jvgcalites/FilipinoSignLanguageToTextConverterUsingKNN/Paper/Filipino Sign Language to Text Converter using K-Nearest Neighbor Algorithm.pdf

i

# Filipino Sign Language to Text Converter

# using K-Nearest Neighbor Algorithm

by

# John Vincent G. Calites

# Jean Tristan L. Reyes

# Glenn Christian D. Sioson

A Design Report Submitted to the School of Electrical Engineering,

## Electronics Engineering, and Computer Engineering in Partial Fulfilment of the Requirements for the Degree

## Bachelor of Science in Computer Engineering

## Mapúa University

## September 2020

ii

## Approval Sheet

## Mapua University

## School of EECE

This is to certify that I have supervised the preparation of and read the design report prepared by John Vincent G. Calites, Jean Tristan L. Reyes, Glenn Christian D. Sioson entitled Filipino Sign Language to Text Converter using K-Nearest Neighbor Algorithm and that the said report has been submitted for final examination on September 23, 2020 by the Oral

Examination Committee.

## Noel B. Linsangan Adviser

## As members of the Oral Examination Committee, we certify that we have

examined this design report, presented before this committee September 23,

## 2020, and hereby recommended that it be accepted in fulfillment of the design requirements for the degree in Bachelor of Science in Computer

Engineering.

Rafael G. Maramba | Meo Vincent C. Caya
Panel Member 1 | Panel Member 2

## Jumelyn L. Torres Committee Chair

This design report is hereby approved and accepted by the School of Electrical,

## Electronics and Computer Engineering in partial fulfillment of the requirements

for the degree in Bachelor of Science in Computer Engineering.

Alejandro H. Ballado, Jr.

## Dean, School of EECE

## iii

## AKNOWLEDGEMENT

## This design project would not be possible without the support of our

## adviser Engr. Noel Linsangan, his guidance kept our work on track from the

initial phase to the finalization of the design project.

We would also like to give thanks first to our parents and family members,

for being the support that was given to us.

## Our Design coordinator, Engr. Jumelyn L. Torres, for being considerate

and understanding to our group.

## We also would like to show our appreciation towards the client for this

design project which is Kaisahan ng Magulang at Anak na may Kapansanan Inc.

(KAISAKA), for giving us the opportunity to be of service to the PWD community.

## Lastly, to our friends and classmates who gives related information and

insights towards the development of this design project.

iv

## TABLE OF CONTENTS

TITLE PAGE | i
APPROVAL SHEET | ii
AKNOWLEDGEMENT | iii
LIST OF TABLES | vii
LIST OF FIGURES | viii
ABSTRACT | x
Chapter 1: DESIGN BACKGROUND AND INTRODUCTION | 1
A. Customer | 2
B. Needs | 2
C. Solution | 3
1. Objectives | 4
2. Scopes and Delimitation | 5
D. Differentiation | 5
E. Benefits | 6
Chapter 2: REVIEW OF RELATED DESIGN LITERATURE AND STUDIES | 8
Technology for Capturing Gestures | 8
Flex Sensor | 9
The mechanism for Filipino Sign Language (FSL) | 9
MPU6050 Gyro Sensor | 10
Force Sensitive Resistors | 11
Interfacing an Android Phone | 12
K-Nearest Neighbor Algorithm | 13
K-Nearest Neighbor Data Pre-Processing | 14
Chapter 3: DESIGN PROCEDURES | 16
A. Design Process Flow | 16

v

B. Hardware Development | 17
a. Conceptual Framework | 18
b. Block Diagram | 20
c. Schematic Diagram | 21
d. Isometric Model | 24
C. Software Development | 25
ATmega328p Microcontroller Programming | 26
Android Application Development | 28
Training Application Development | 34
D. Prototype Development | 37
a. PCB Design | 38
b. PCB Component Diagram | 39
c. Casing Model of the Prototype | 40
d. Bill of Materials | 41
E. Multiple Design Constraints | 42
F. Trade-offs | 43
G. Selection of Alternative Solution | 44
H. Impact of Design Solution | 46
I. Engineering Principles | 48
J. Modern Engineering Tools | 49
Chapter 4: TESTING, PRESENTATION, AND INTERPRETATION OF DATA | 50
A. Picking the K value | 50
B. Purpose of the Test | 50
C. Initial Assumptions | 50
D. Procedures in picking the K Value | 50
E. Data Table for the value of K | 52
F. Analysis and interpretations of collected data | 57
A. Testing the Android Application | 57
B. Purpose of the Test | 57
C. Procedures in Testing the Application | 58
D. Initial Assumption | 58
E. Data Table for the Android Application | 59

vi

F. Analysis and interpretations of collected data | 60
Chapter 5: CONCLUSION AND RECOMMENDATION | 61
Conclusion | 61
Recommendation | 61
Bibliography | 62
Appendix | 63
A. Article | 63
B. Operation’s Manual | 63
1. System Requirements | 63
2. Installation Procedures for the Android Application | 64
3. User’s Manual | 64
4. Troubleshooting Guides and Procedures | 64
C. Pictures of Prototype | 65
D. Data Sheets | 67
E. Android Application | 75

## vii

## LIST OF TABLES

Table 1.1: Differentiation from Previous Work | 6
Table 3.1: Tabulated Bill of Materials | 41
Table 3.2: Decision Martix of Design Constraints | 42
Table 3.3: Decision Matrix for Usability Constraint | 44
Table 3.4: Decision Matrix for Sustainability Constraint | 45
Table 3.5: Decision Matrix for Ergonomics Constraint | 46
Table 4.1: Picking the value of K (Trial 1) | 52
Table 4.2: Picking the value of K (Trial 2) | 53
Table 4.3: Picking the value of K (Trial 3) | 54
Table 4.4: Picking the value of K (Trial 4) | 55
Table 4.5: Picking the value of K (Trial 5) | 56
Table 4.6: Picking the value of K (Summary of 5 Trials) | 57
Table 4:7: Android Application Testing | 59

## viii

## LIST OF FIGURES

Figure 2.1: Comparison of Flex Sensor resistance | 9 (https://mymailmapuaedu-my.sharepoint.com/personal/gcdsioson_mymail_mapua_edu_ph/Documents/COE124D%20CALITES%20REYES%20SIOSON%20Final.docx)
Figure 2.2: Filipino Sign language alphabet | 10
Figure 2.3: MPU6050 Pin diagram and orientation | 11 (https://mymailmapuaedu-my.sharepoint.com/personal/gcdsioson_mymail_mapua_edu_ph/Documents/COE124D%20CALITES%20REYES%20SIOSON%20Final.docx)
Figure 2.4: FSR Connection | 12 (https://mymailmapuaedu-my.sharepoint.com/personal/gcdsioson_mymail_mapua_edu_ph/Documents/COE124D%20CALITES%20REYES%20SIOSON%20Final.docx)
Figure 2.5: Similar datapoints existing close to each other | 13
Figure 2.6: Sign Language Database | 14 (https://mymailmapuaedu-my.sharepoint.com/personal/gcdsioson_mymail_mapua_edu_ph/Documents/COE124D%20CALITES%20REYES%20SIOSON%20Final.docx)
Figure 3.1: Design Process Flow | 16
Figure 3.2: Conceptual Framework | 18 (https://mymailmapuaedu-my.sharepoint.com/personal/gcdsioson_mymail_mapua_edu_ph/Documents/COE124D%20CALITES%20REYES%20SIOSON%20Final.docx)
Figure 3.3: Block Diagram for the Design Project | 20
Figure 3.4.1: Schematic Diagram for the Main Module | 21 (https://mymailmapuaedu-my.sharepoint.com/personal/gcdsioson_mymail_mapua_edu_ph/Documents/COE124D%20CALITES%20REYES%20SIOSON%20Final.docx)
Figure 3.4.2: Schematic Diagram for the Battery Module | 22 (https://mymailmapuaedu-my.sharepoint.com/personal/gcdsioson_mymail_mapua_edu_ph/Documents/COE124D%20CALITES%20REYES%20SIOSON%20Final.docx)
Figure 3.5: Isometric Model of the Prototype | 24
Figure 3.6: ATmega328p Program Flowchart | 26
Figure 3.7: SendSensorValue module flowchart | 27
Figure 3.8.1: Android Development Flowchart | 29 (https://mymailmapuaedu-my.sharepoint.com/personal/gcdsioson_mymail_mapua_edu_ph/Documents/COE124D%20CALITES%20REYES%20SIOSON%20Final.docx)
Figure 3.8.2: Android Development Flowchart | 30 (https://mymailmapuaedu-my.sharepoint.com/personal/gcdsioson_mymail_mapua_edu_ph/Documents/COE124D%20CALITES%20REYES%20SIOSON%20Final.docx)
Figure 3.8.3: Extracting Sensor Values from a single string | 32 (https://mymailmapuaedu-my.sharepoint.com/personal/gcdsioson_mymail_mapua_edu_ph/Documents/COE124D%20CALITES%20REYES%20SIOSON%20Final.docx)
Figure 3.9: ClassifyGesture() Flowchart | 33 (https://mymailmapuaedu-my.sharepoint.com/personal/gcdsioson_mymail_mapua_edu_ph/Documents/COE124D%20CALITES%20REYES%20SIOSON%20Final.docx)
Figure 3.10: System Flowchart for Training Application | 35
Figure 3.11: Main Module PCB Design | 38
Figure 3.12: Battery Module PCB Design | 38

ix

Figure 3.13: Main Module PCB Component Diagram | 39
Figure 3.14: Battery Module PCB Component Diagram | 39
Figure 3.15: Components used in the Prototype | 40

x

## ABSTRACT

The Philippines has recognized Filipino Sign Language as the national sign language of the Filipino deaf and the official sign language of the government (RA 11106), this involves all the transactions involving the deaf, its usage in schools, broadcast media, and workplaces. This design project develops a glove that will translate Filipino Sign Language (FSL) to text using the K-Nearest Neighbor (KNN) algorithm. The device will only translate the alphabet instead of words. The device, while worn by the user, will do a real-time language translation through the means of capturing hand movements and gestures. The device is portable in the sense that it will only need an android phone in viewing the translated gesture while connected to the gloves through Bluetooth. After conducting several tests, it shows an accuracy of 89.63% when translating FSL

to text.

## Keywords: Android, Bluetooth, FSL, Gestures, Hand movements

## Chapter 1

## BACKGROUND AND INTRODUCTION

## Hearing impairment is the decreased ability to hear a sound which can

## occur at any age. Hearing disability can be acquired due to some genetic factors

## which can make a newly born child deaf, or people at any age can become deaf

due to complications, diseases, nerve damages, or injuries.

## Communication plays a vital role in society; it employs the transfer of

## information that is essential in developing relations. People who are deaf and has

other forms of hearing impairment hinders them to properly communicate.

## Although other forms of communication for them exists, such as sign language, it

## is not understood by many. Thus, the communication for those who have little to

## no knowledge of sign language and people with hearing disabilities must be

addressed.

## On October 30, 2018, the Philippines has recognized Filipino Sign

## Language as the national sign language of the Filipino deaf and the official sign

## language of the government (RA 11106), this involves all the transactions

## involving the deaf, its usage in schools, broadcast media, and workplaces. Since

## most of the schools use American Sign Language (ASL), various government

## offices such as the DepEd, CHED, and TESDA and all national and local

## government authorities involving the deaf are tasked to use the Filipino Sign

Language (FSL) as the medium of instruction for education.

## A. Customer

## The customer for this design project is Kaisahan ng Magulang at Anak na

## may Kapansanan Inc. (KAISAKA), a Community Based Rehabilitation (CBR)

## program for children and young adults with disability and their families based in

## the urban poor community of Manila; and the contact person of the said

## organization is Ms. Jeannifer Villanueva, the Program Coordinator. The

## organization started as a parish outreach program in 1989, KAISAKA, Inc. was

## registered in the Securities and Exchange Commission (SEC) as a People’s

## Organization (PO). On August 6, 1998, with mothers and people with disabilities

themselves as the frontrunner of the program.

## B. Needs

## After the initial interview with Ms. Jeannifer Villanueva, some of the

## officers of the said organization which directly deals with the PWD’s have low

## proficiency regarding Filipino sign language, thus they encounter difficulty when

## communicating with deaf people. Since they are a non-profit organization, they

## do not have sufficient funds to be able to hire translators all the time, it will also

## take time to fully learn and study Filipino Sign Language. As one of the officers

## said, they barely understand Filipino sign language, and most of the time they

## have a hard time understanding it; this is because their organization is not

## limited in accommodating the deaf, but a variety of PWDs. The need of the client

## is a device that can aid the officers in understanding deaf people. The device

## must also be easy to use, making it usable even by children. It must also be

portable in such a way that it can be used in everyday situations.

## C. Solution

## As a response to the need of the client, the group intends to create a

## device that will help by providing a means of training officers, volunteers, or

those persons with disabilities in Filipino Sign Language.

## The proposed solution is a glove that will translate Filipino Sign Language

## (FSL) to text, which can be viewed on an android phone. The device is portable

## in the sense that it will only need an android phone in viewing the translated

## gesture. The glove, while worn by the user, will do a real-time language

## translation through the means of capturing hand movements and gestures. The

## movement and gesture of the hand will serve as the input data, these data could

## be gathered by providing data to the microcontroller coming from the flex

## sensors, gyroscope, and accelerometer. The flex sensors will be responsible for

## taking the bending motion of the fingers. The gyroscope and accelerometer will

## take the position and speed of the hand in motion. Combining these three data

inputs, the interpretation of a specific gesture could be possible.

## The data coming from the sensors will then be sent by the microcontroller

## to the connected Android phone using a Bluetooth module. In the android

## phone, the hand movement and gesture are interpreted through the K-nearest

neighbor algorithm that predicts the output using the created mobile application.

## The force-sensitive resistor will be pressed for the device to start translating the

## sign language to text. The device will be powered by a rechargeable battery with

a charging module.

## In terms of how the device will be made, the group plans to design it as

## small as possible for the user to be able to move his hand and make gestures

## comfortably. The flex sensors will be placed along with the fingers. The gyro

## sensor is placed on the back of the hand while the force sensitive resistor will be

## placed at the thenar space (between the thumb and index finger). The

## microcontroller, Bluetooth module, and the battery along with the charging

## module will be placed on top of the wrist. A small and compact PCB will be

designed to connect all these components.

## 1. Objectives

## In this design project, the group intends to develop a real-time language

## translation of Filipino Sign Language (FSL) to text. Specifically, the group wants

## to achieve the following:

## 1. To use a flex sensor, gyroscope, and accelerometer to capture hand

movements and gestures.

## 2. To create a portable device utilizing an Android application capable of

translating Filipino Sign Language (FSL) to text.

3. To use the K-Nearest Neighbor Algorithm for classifying gestures.

## 2. Scopes and Delimitation

## The android device only translates the alphabets in Filipino Sign Language

## (FSL) to text. Only the right-hand glove will be designed and built for

## gesture recognition. The output text will be based only on the data

## gathered from the glove. Facial expressions, head movement, body

## positions, and proximity of the hands to each other are not translatable by

## the device. The microcontroller will only send the data coming from the

sensor to the android phone once the force sensitive resistor is pressed,

## this is done so that it will only send data to the android phone when the

## user wants to fingerspell a letter and to avoid transmitting data when it is

## idle. Only one android phone can be paired to the glove to view the

## translated texts. The android phone will be used to process the data and

## convert the signals to text rather than the ATmega328p microcontroller

since KNN uses large amounts of resources.

## D. Differentiation

## A thesis published from Mapua Institute of Technology Manila: MIT School

## of Graduate Studies, “A heuristic decision tree algorithm for Filipino Sign

## Language (FSL) translator implemented using accelerometers with Bluetooth

## connectivity to a host PC” (Piscasio,2014) was found to have a similar problem to

## solve, to bridge the communication gap between signers and non-signers. There

## are however some differences in the implementation of the solution to the

## problem. The design to be implemented aims to make the device portable for it

## to be usable in an everyday situation as compared to the work of Piscasio that

## uses a PC as the output and processing device. There are also differences in the

## components, method, and technology used as seen in Table 1.1. Our group will

## use the ATmega328p microcontroller and translate Filipino Sign Language (FSL)

## to text and will have a rechargeable battery. Lastly, the machine learning

## algorithm that the group will use is the K-Nearest Neighbor algorithm, unlike the

similar device which uses a Heuristic Decision Tree.

## Table 1.1: Differentiation from Previous Work

Design Solution | Nearest Similarity
Technology | Microcontroller: ATmega382p Sensors: Flex Sensors Force Sensitive Resistors MPU6050 Sensor Algorithm: K-Nearest Neighbor | Microcontroller: ATmega2560 Sensors: Accelerometer Algorithm Heuristic Decision Tree
Functionality | Converts Filipino Sign Language to Text | Converts Filipino Sign Language to Text
Features | Portable Rechargeable Uses Android phone | Uses PC

## E. Benefits

## The product is made specifically to benefit the officers of the organization

## who have little knowledge about Filipino Sign Language (FSL) and have a hard

## time understanding it. This product will also benefit the deaf people of whom the

## organization helps, since they can now train by themselves and their knowledge

## will be reinforced by showing them if their gesture is correct. The product is

## being designed and built as a compact and portable device, making it easier to

## be carried around, thus it can be used anywhere when needed. The device can

## help those who are beginners in terms of FSL for them to learn the basics of sign

language which is fingerspelling.

## Chapter 2

## REVIEW OF RELATED LITERATURE AND STUDIES

## This chapter involves related studies and developments of the design of

## the Filipino Sign Language (FSL) to text converter. The researchers will give an

## overview to its readers how this study’s design works and develop a new

concept.

## Technology for Capturing Gestures

## Language translation can be done through the use of electromagnetic

sensors that have direct contact with the skin along with accelerometers,

## gyroscopes, and vision through means of a supervised machine learning

## algorithm requiring the user up to 30 minutes of training per gesture. The

## algorithm consists of different type of machine learning algorithm which includes

## Naïve Bayes, Nearest Neighbor, decision trees, and vector machines which

## enables the comparison for accuracy of 40 common gestures. An important

## consideration in creating a communication device is by following the safety

## standards. To bring a device as close as a commercial product, it must follow the

safety standard like prevention of shorting wires that might cause injuries. Also,

## electrocution must be prevented through means of having a total voltage lower

## than 25V which was referred to as the lowest lethal voltage by a research paper

completed at the City University of New York.

## Flex Sensor

## A flex sensor is a variable resistor, its resistance increases as the

## component bends. One side of the Flex Sensor is made out of polymer ink which

## has conductive particles. When the flex sensor is straight, it gives the polymer

## ink resistance of approximately 30kΩ, when bent, it gives around 50kΩ~70kΩ

depending on the degrees it is bent.

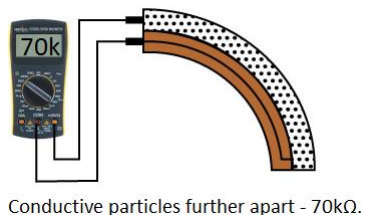
[picture p13: figure]
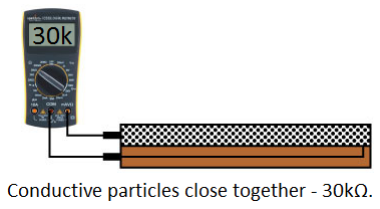
[picture p14: figure]

A voltage divider will be required in incorporating the sensor to a project,

## it must be connected in the Arduino’s A0 port and the other end at 5V. When

## developing the program, the straight and bend resistance must be declared. And

then calculate for the resistance using various formulas.

## The mechanism for Filipino Sign Language (FSL)

## Sign Language is not an international language, but those who use sign

## language may understand fellow sign language users quickly because there are

## universal features in sign languages as stated by the World Federation of the

## Deaf. Filipino Sign Language is used by deaf people in the Philippines, this is

## distinct in comparison to the American Sign language (ASL) because Filipino sign

## Figure 2.1: Comparison of Flex Sensor resistance

language poses unique structural features in terms of its phonology, morphology,

syntax, and discourse.

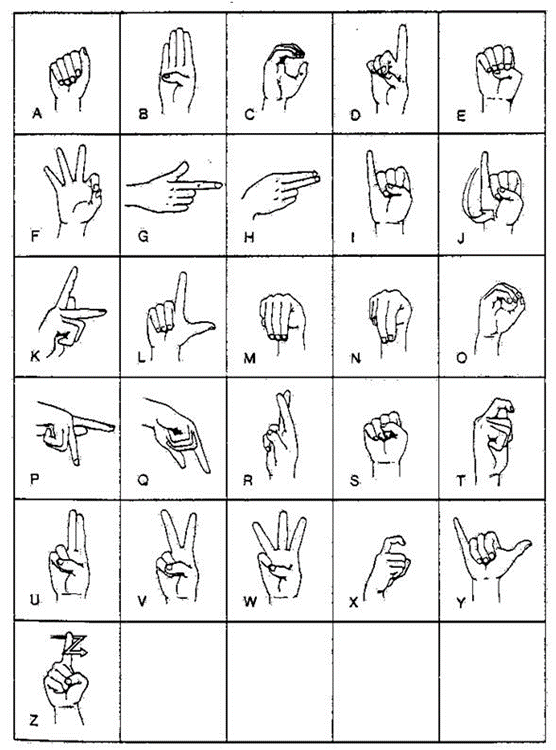
[picture p15: figure]

## Figure 2.2: Filipino Sign language alphabet

## MPU6050 Gyro Sensor

## The MPU6050 is an 8-pin with 6 axis chip that combines the

## accelerometer and a gyro. To use the Gyro Sensor, pin 18 (GND) must be

## connected to the ground, 3.3V must be connected to pin 13 (VDD). Pin 23 (SCL)

## and Pin 24 (SDA) of the MPU6050 must be connected to the A4 pin and A5 pin of

## the microcontroller respectively. The data pin is directly connected to the digital

## PINs 10-13. To program using the MPU6050 Sensor, a library must be imported

## from GitHub and install it in the IDE. This library supports reading and displaying

## gyro and accelerometer readings. The Gyro sensor uses the earth’s gravity to

## determine the x-axis, y-axis, and z-axis position of the sensor while the

accelerometer detects based on the movement.

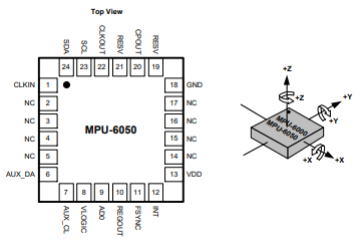
[picture p16: figure]

## Force Sensitive Resistors

## FSRs are simple and low-cost sensors that allow the detection of pressure

## and weight. It is made of 2 layers which are the flexible substrate with printed

## semiconductor and a flexible substrate with printed interdigitating electrodes

## which are separated by a spacer. The resistance of the FSR changes as pressure

## is applied. When no pressure is applied, the FSR acts as a resistor, as pressure is

## applied the resistance decreases. One end must be connected to a 5V supply

while the other end is connected to the analog input.

## Figure 2.3: MPU6050 Pin diagram and orientation

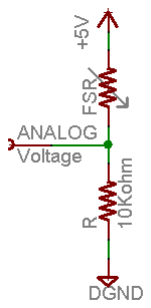
[picture p17: figure]

## The voltage of the Force Sensitive Resistor can be computed as vo = vcc (

R
R+FSR),

## whereas Vo is the output voltage, Vcc being equal to 5V, FSR being the resistance

## of the force-sensitive resistor when 0 pressure is applied and lastly R being the

value of the pull-up resistor.

## Interfacing an Android Phone

## Interfacing an Android phone with Arduino via Bluetooth is possible

through the use of a Bluetooth module. Connect first the Pin 0 (RX) to TX,

## TX(Pin 1) to RX, VCC, and ground accordingly. Turning on the microcontroller

## also powers up the HC 05/06 Bluetooth module, the android phone needs to be

## paired via Bluetooth by entering the default password which can either be 1234

## or 0000. After a successful connection, data transfers via Bluetooth can now be

used.

## Figure 2.4: FSR Connection

## K-Nearest Neighbor Algorithm

## It is a supervised machine learning algorithm that is dependent on labeled

## data inputs to learn and will produce an output based on the newly given input

## unlabeled data. This is commonly used to solve classification and regression

problems. This algorithm assumes that similar things exist in proximity.

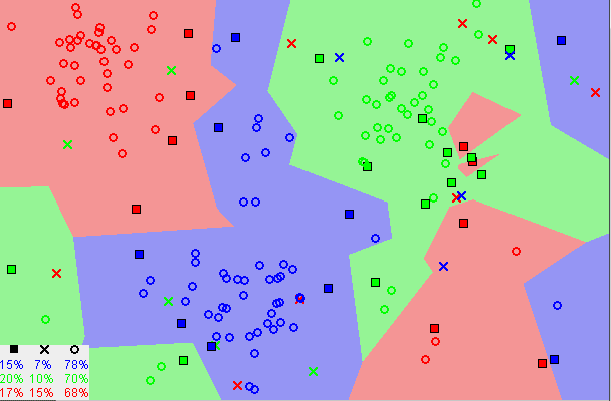
[picture p18: figure]

## Figure 2.5: Similar datapoints existing close to each other

## Figure 2.5 shows that most of the time, similar data points are located

## close enough from each other. The KNN algorithm bases on this assumption

## being true, it captures the idea of similarity. Several steps are required in using

the K-Nearest Neighbor algorithm, these are as follows;

## 1. Load the data

## 2. Initialize the value of K to the number of chosen neighbors

## 3. For each sample data, compare the distance between the query

## example and current example then add the distance along with its

## index to an ordered collection

## 4. Sort the ordered collection of distances and indices in ascending order

## 5. Pick the first K entry

## 6. Get the labels of the selected entry

## 7. Return the mean or the mode of the K labels if it is a regression

## (mean) or classification (mode)

## K-Nearest Neighbor Data Pre-Processing

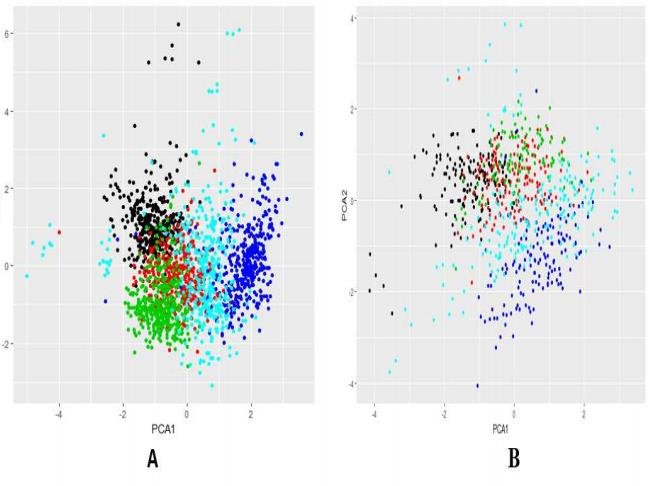
[picture p19: figure]

## When implementing a complex prototype selection algorithm with regards

## to a large scale of data, the execution time needed to accomplish the task is long

## due to the repeated iterations in the training set. The gloves acquire the data

## from the flexion of the sensors when performing different sign languages, thus a

## Figure 2.6: Sign Language Database

## large number of data are stored, which needs to be pre-processed. The data

which are like the noise to the database are then removed. For data acquisition,

the gesture must be done for several minutes for one minute in each position.

## These data are stored in the new matrix T, of m x n order wherein the value of

## m is the number of samples and the variable n is the number of attributes that

represent the data.

Figure 2.6 illustrates in part A the matrix T and in part B the matrix U,

colors: black (number 1), red (number 2), green (number 3), blue (number 4),

and cyan (number 5).

## Chapter 3

## DESIGN PROCEDURES

## In compliance with the client’s needs, the researchers have designed the

## Filipino Sign Language (FSL) to text converter. In this chapter, the stages of

designing the system that will comply with the needs of the client are discussed.

## A. Design Process Flow

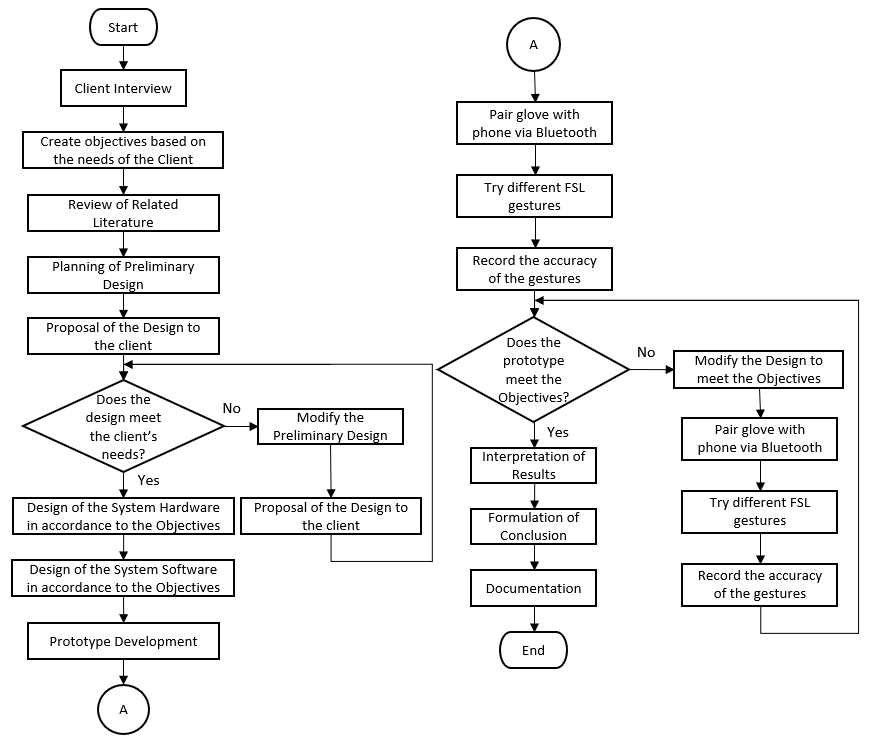
[picture p20: figure]

## Figure 3.1: Design Process Flow

## Figure 3.1 illustrates the flow of design development. First, the client was

## interviewed to know their needs with regard to the existing problems of persons

## with physical disabilities. Then the objectives were established under the needs

## of the client. The researchers then read documents, journals, and previous

## studies to have an idea of how the problem will be solved. After formulating

## concepts for the solution, the next step is to meet and discuss with the clients if

## the proposed solution meets the client’s needs, if not, the design is modified and

## is discussed again with the client. If the design is approved by the client, the

## next step is to design the hardware part of the design which includes the listing

## of components needed and creating the schematic diagram. Next is to design the

## software part of the system, this will describe the logical flow of the system using

## programming. Then the hardware design will be implemented to form the actual

## hardware as well as the software to be uploaded into the microcontroller to build

## the prototype of the system. Testing and data gathering will be conducted to see

## if the prototype functions in accordance with the objectives. The glove and the

## app are tested with different gestures, and the accuracy for each gesture is

## recorded. If it meets the objectives, the results are interpreted and conclusions

## are formed, if not then the current prototype is modified and tested until the

## objectives are met. The last step of the design process flow is the documentation

of the project.

## B. Hardware Development

## Step-by-Step Procedure of Hardware Development

## 1. Identify the needed components to be used; the major materials are:

a. ATmega328p – The microcontroller that will be used.

## b. HC05 Bluetooth Module – Used in transmitting converted FSL to an

android phone.

c. Flex Sensor – Used to measure the flexion of the fingers.

## d. FSR 400 – Used to identify whether the device should translate or

not.

## e. MPU6050 – Used to measure the orientation of the hand and the

speed at which the hand is moving.

f. TP4056 Module – Used to charge the batteries.
g. Gloves – Used to hold the components.
h. 14500 Li-Ion Battery – Used to power the device.
2. Construct a block diagram that will show the hardware design flow.
3. Create a schematic diagram for the FSL Translator Circuit.

## a. Conceptual Framework

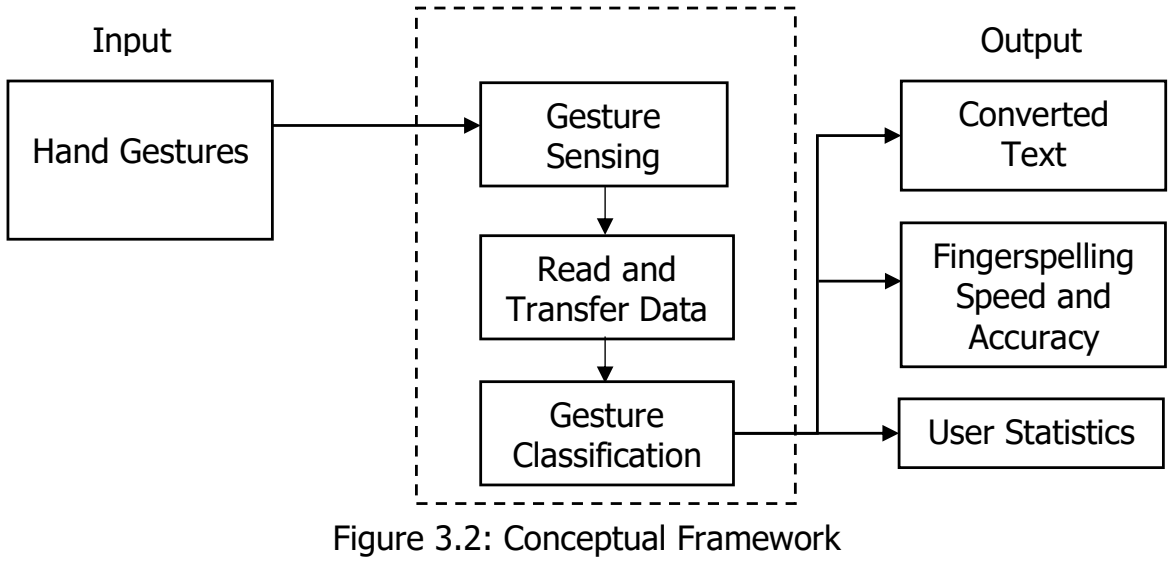
[picture p21: figure]
Fingerspelling Speed and Accuracy; User Statistics; Input; Process; Output; Hand Gestures; Converted Text; Gesture Sensing; Read and Transfer Data; Gesture Classification

## Figure 3.2: Conce Figure 3.2: Conceptual Framework ptual Framework

## Figure 3.2 shows the conceptual framework of the system. The input will

## come from the hand gestures of the user that corresponds to the Filipino Sign

## Language (FSL). There will be sensors providing the data from the hand

## gestures. The data will be read by the microcontroller and will be sent to the

## android phone via Bluetooth connection. It will only be sent to the android

## application once the FSR is pressed. In the android phone, the data will be

## processed using the Machine Learning Model that is trained using the K-Nearest

## Neighbor Algorithm which finds the most frequent label for a given value of K on

## the trained data. Lastly, the label’s equivalent text will be displayed on the

## android phone. The user can also see how fast and accurate his/her

## fingerspelling is after fingerspelling a sentence, this contains the words

## translated per minute and accuracy. The user can also view their progress

through a line graph displaying their records which includes the games played,

speed record, average speed, and accuracy.

## b. Block Diagram

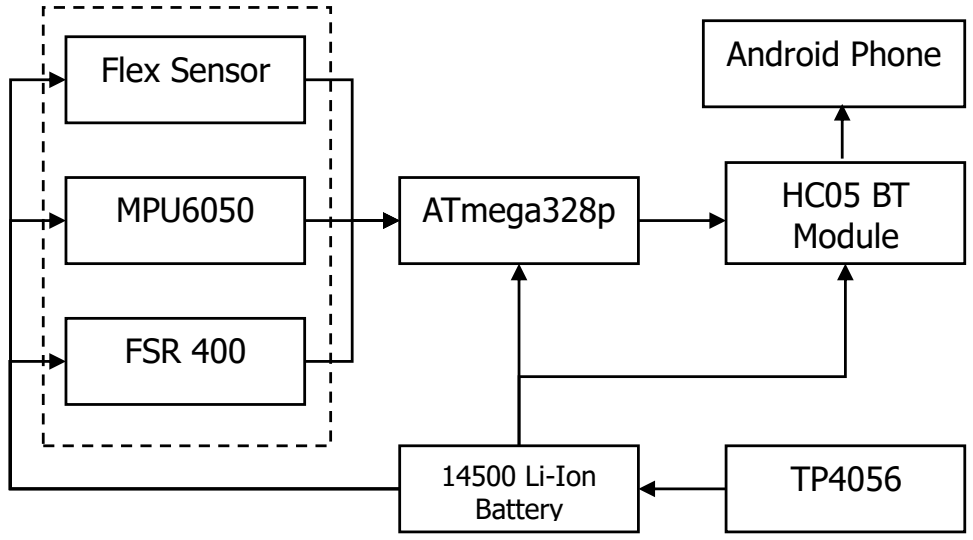
[picture p22: figure]
HC05 BT Module; Flex Sensor; MPU6050; FSR 400; ATmega328p; 14500 Li-Ion Battery; Android Phone

## Figure 3.3: Block Diagram for the Design Project

Figure 3.3 illustrates the interaction among the components of the device.

## The microcontroller ATmega328p will serve as the controller for the system in

## which it controls and reads data from the different components. The

ATmega328p reads the resistance coming from the flex sensor, the acceleration,

## and position from the MPU6050, and if the device is ready to translate by

## pressing the FSR. The microcontroller then sends it to the android phone through

## means of Bluetooth connection. Then, the smartphone uses the data gathered by

## the sensors to interpret the gesture through a given set of algorithms and

translates it accordingly. The translated text will be displayed on the smartphone.

## The power will come from the battery that is rechargeable through means of the

TP4056.

## c. Schematic Diagram

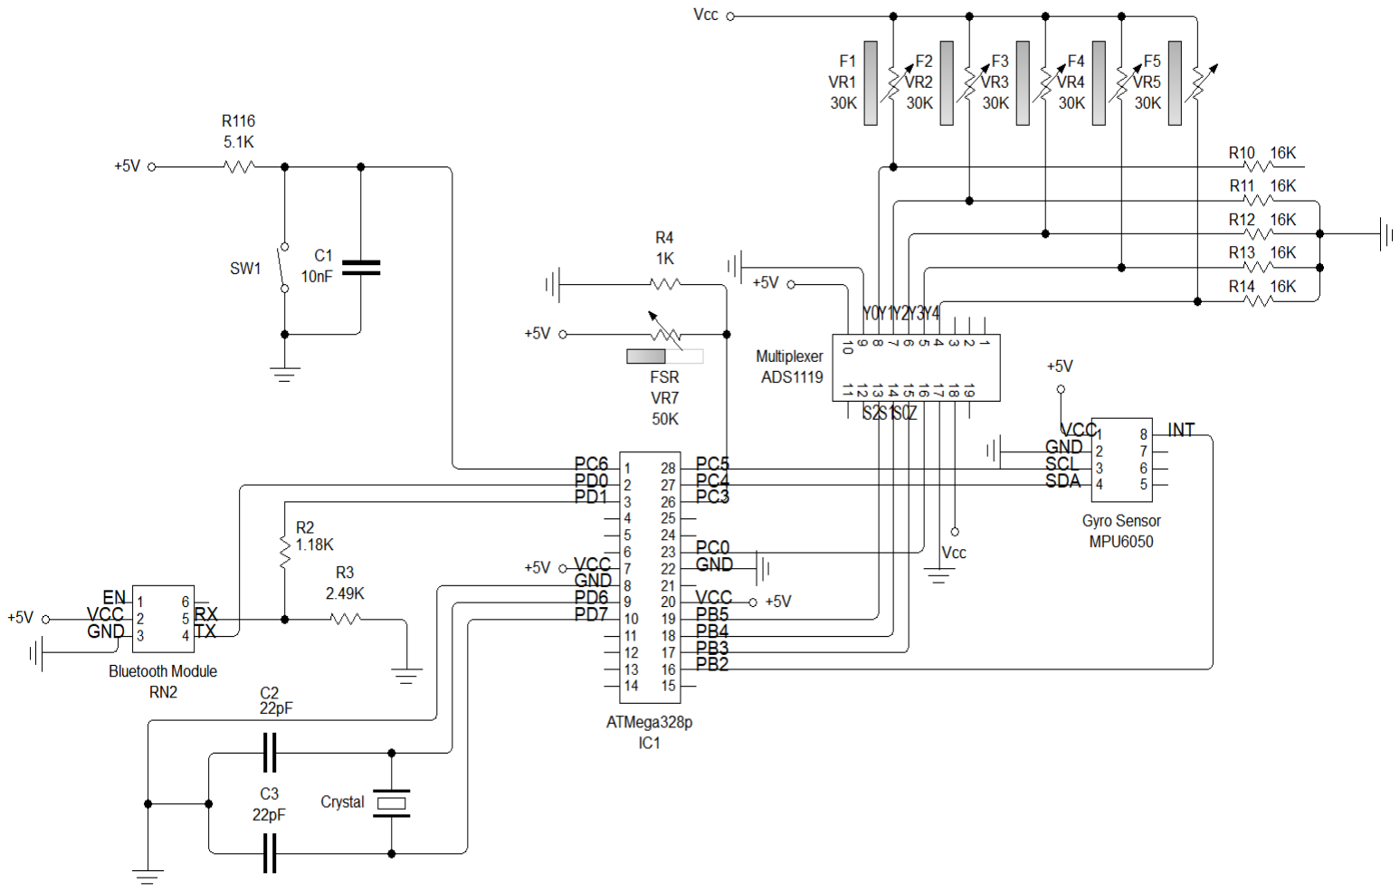
[picture p23: figure]

## Figure 3.4.1: Schematic Diagram for the Main Module

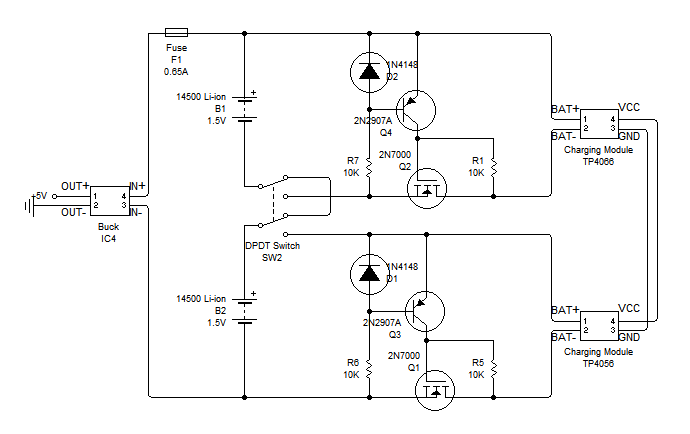
[picture p24: figure]

## The schematic diagram is illustrated in figure 3.4.1 and figure 3.4.2. The

## microcontroller is powered by 2 pieces of 3.7V Li-ion battery which uses the buck

converter to step down the output to 5V, it is then | connected | at the DPDT

## switch. The FSR400 is connected to pin 26 of the microcontroller, once pressed

## the FSR lowers its resistance, thus the FSR enables the sign language translation

## when it is pressed. The pin 7 of the microcontroller which is the VCC is

## connected to the output voltage of the buck converter while 8 and 22 of the

microcontroller are connected to the ground.

The microcontroller is short of analog input pins thus an extender is used,

## this multiplexer is used for the connection of the flex sensors. The RX and TX

## pins of the HC05 Bluetooth module are connected in pins 2 and 3 of the

## ATMega328p which are the RXD and the TXD pins respectively, this is used for

## Figure 3.4.2: Schematic Diagram for the Battery Module

communication between the ATmega328p board and the other devices serially.

## Pins 9 and 10 of the ATmega328P microcontroller is also connected to a 16Mhz

Crystal Oscillator with both ends being connected to a 22pF capacitor.

## The data signal pin of the pin 24 of the MPU6050 is the SDA, this is

## connected to the pin 27 of the microcontroller which permits the data to be

## transferred from the gyro sensor to the microcontroller, the pin 28 of the

microcontroller is connected to the SCL or the clock of the MPU6050.

## A TP4056 is connected to the battery which enables the lithium-ion

## battery to charge. Although, in the case of inserting the battery incorrectly, it will

## cause reverse polarity, and will end up damaging the circuit. To prevent this, a

## circuit was created for reverse polarity protection. A MOSFET was placed

## between the battery and charging module. When off, the MOSFET does not let

any current through, effectively opening the circuit like a reverse-polarized diode.

## When ON, it behaves more like a resistor with very low resistance, causing a

voltage drop that decreases as the cell becomes full and the current slows down.

## A resistor was placed from the source to the gate to make sure the MOSFET is

## off by default and a transistor is added to override the resistor and flip the

## voltage on the gate when the battery is correctly positioned. The values for the

## limiting resistors are computed using the formula V = IR, whereas a two 3.7V

## batteries in series have a current of I=0.0011A and a voltage of V=3.4V, the

## value for R can be computed. This resulted in the formula R =

Vt−Vi
I

## wherein VT

## is the total input voltage which is equal to 7.4V and Vo is the output voltage that

## is equal to 3.4V, by substituting the values will result in an approximate value of

3650 | Ω. | The fuse rating that will be used for the circuit is 0.65A, from the

## formula Fuse Rating = Wattage / Voltage x 1.25, where the values for the power

and voltage are based on the datasheet of 14500 Li-ion battery.

## d. Isometric Model

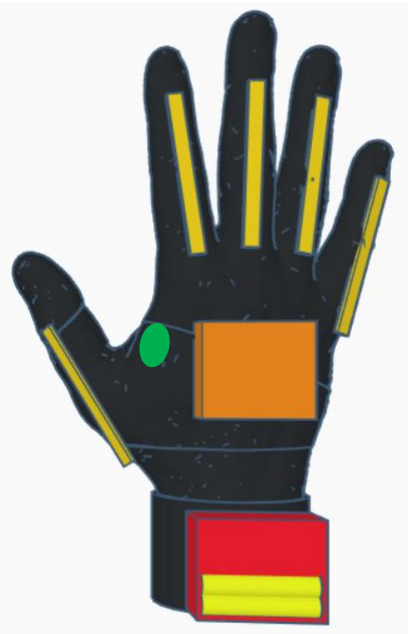
[picture p25: figure]

## Figure 3.5: Isometric Model of the Prototype

## Figure 3.5 illustrates the isometric model of the design. The design will be

## compact for the user to freely move the hand and make gestures with ease. The

## components will be placed at the top of the wrist for simple wiring, this includes

## the ATmega328p, TP4056 as well as the battery that will be contained in a

## compact case that is placed along the top of the wrist. The flex sensors will be

## placed on top of the fingers. The force-sensitive resistor is placed on the thenar

## space, while the gyro sensor is placed on the back of the hand. To provide safety

## for the user, the case for the ATmega328P together with the other components

will both be properly insulated.

## C. Software Development

## The device requires a program that will take the input data coming

## from the flex sensors, accelerometer, and gyroscope, and output the equivalent

## text in the android application. For this to happen, the group needs to work on

## the program for the Microcontroller, the Android Application, and the Training

Application.

## Step-by-Step Procedure of Software Development

1. Identify the needs of the program that must be satisfied.

## 2. Plan the program’s logic and create a system flowchart that contains the

steps of the program.

## 3. Prepare the software to be used in building the program such as IDE and

programming language to be used.

4. Construct the code of the program.
5. Test the program for syntax and logical errors.
6. Deploy the program to the device.

## ATmega328p Microcontroller Programming

## Needs of the Program that must be satisfied

## The program must be able to let the ATmega328p microcontroller to

## receive data from the flex sensors, accelerometer, gyroscope, and force resistive

resistor and send it to the Android phone via Bluetooth.

## ATmega328p Flowchart

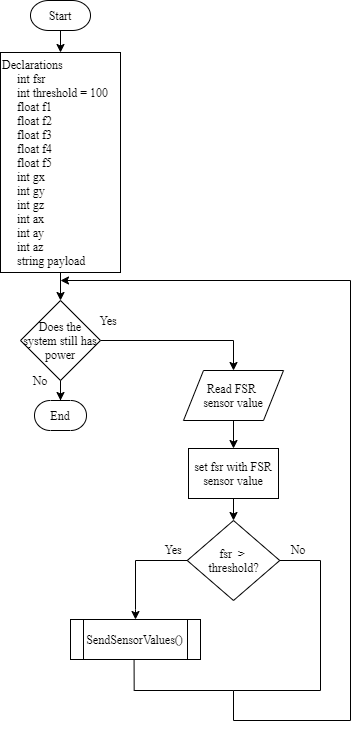
[picture p26: figure]

## Figure 3.6: ATmega328p Program Flowchart

## Figure 3.6 shows the flow of the program that is being implemented on

## the microcontroller. All the variables to be used are declared at the start of the

program. From here, the program will loop until the system gets powered down.

## While the system has power, it will read the Force Sensitive Resistor (FSR)

## Sensor value. If the FSR value is greater than the given threshold, the module in

Figure 3.7 will be used.

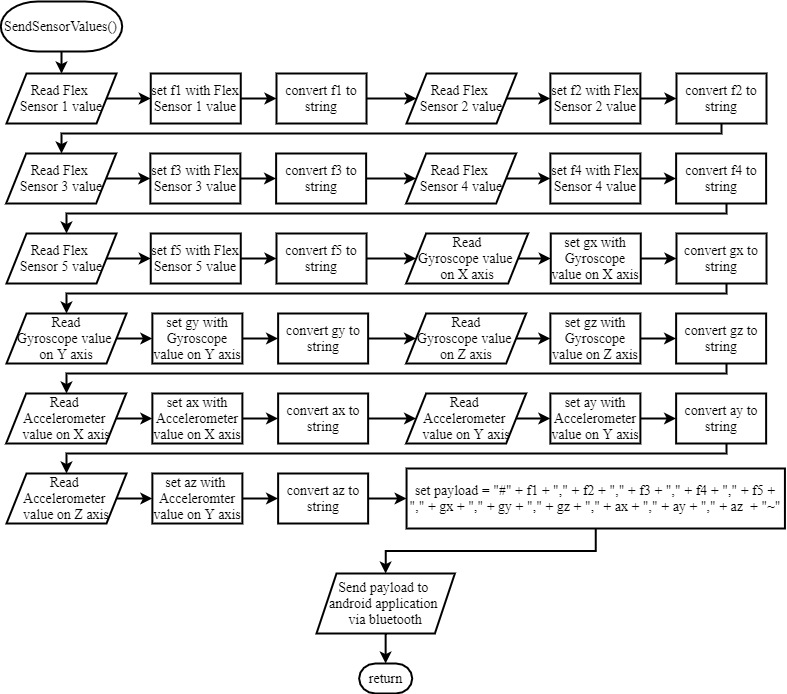
[picture p27: figure]

## Figure 3.7: SendSensorValue module flowchart

## Figure 3.7 shows the module to be used when the FSR reached the

## threshold value. This module reads all the value of Flex Sensors, Gyroscope, and

## Accelerometer, assign each sensor readings to variables, and converts all the

## variables to a string. The variables are then concatenated with delimiters to

produce a specific format that will be able to parse by the android application.

## Preparing the Software to be used

## In writing and uploading the code to the microcontroller, the open-source

## Arduino Software (IDE) will be used. It is an IDE especially made for Arduino and

it uses C/C++ as its programming language.

## Android Application Development

## Needs of the Program that must be satisfied

## The main purpose of developing an Android application is to display the

## equivalent text of a corresponding gesture. To implement this, the application

## should be able to let the Android phone to connect and receive sensor data from

## the microcontroller, classify the input data using K-Nearest Neighbor Algorithm

Model, and display the output letter as text on the screen of the android phone.

It must also provide a simple and friendly user interface, for easier use.

## Android Application Flowchart

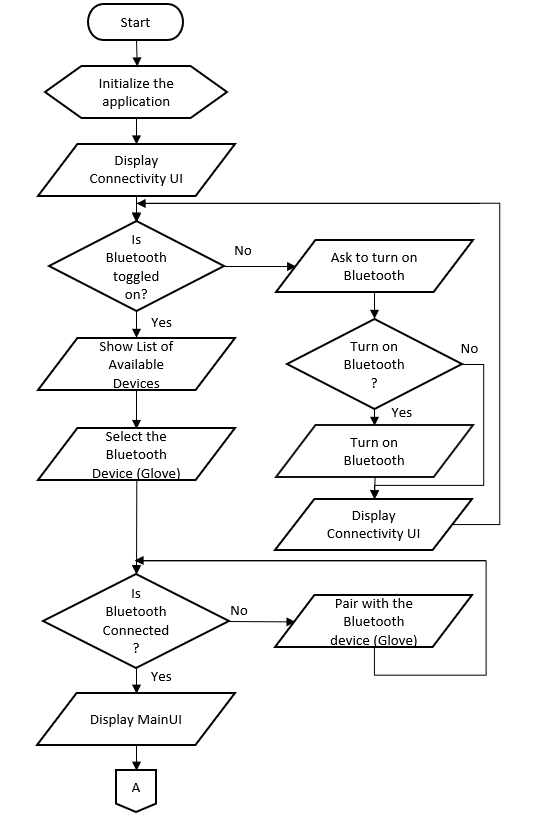
[picture p28: figure]

## Figure 3.8.1: Android Development Flowchart

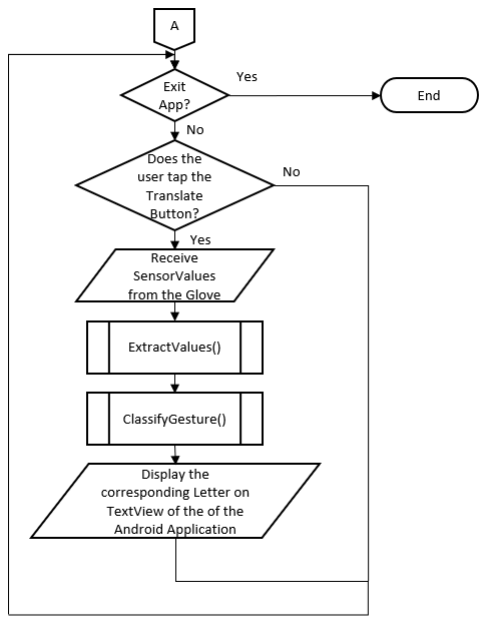
[picture p29: figure]

## Figure 3.8.1, 3.8.2, and 3.8.3 illustrates the flow of the program of the

## android application. As the application starts, the application will initialize and

## show the user interface for connectivity. A toggle switch is available for

## activating the phone’s Bluetooth. Once activated, the application will show a list

## of available devices to connect. The user must choose the glove as the device to

## connect to. Once connected, the main user interface will appear. The main user

## Figure 3.8.2: Android Development Flowchart

## interface contains a toggle switch for the translate function and a textbox for

viewing of text.

## While the toggle switch is on, the input data from the microcontroller is

## read and will be used for classifying the hand gestures’ equivalent letter. The

## letters will be displayed as text and can be viewed in the textbox, one letter at a

time. The program will end when the user exits from the application.

## Figure 3.9 illustrates the function to classify gestures. Variables to be used

## within the function are declared at the start of the function. The content of the

## totalTrainedData variable will be initialized by the total number of trained data of

## our data set. Then get the computed distance from our testInput to each

## trainedInput in the data set and store it in the list of distance, this is computed

using equation 3.1.

## distance = √∑ (xi − yi)

k | 2
i=1

(3.1)

## After getting all the distances, sort the list of distances in increasing

## order. In this way, we can get the K-nearest distances from the list of distance

## and get all their trainedLabels. All the trainedLabels will be stored in the list of

## targets. Now that we have the list of trainedLabels within the range of K, we can

## get the most common trainedLabel in the list and set it as the outputLabel of the

testInput.

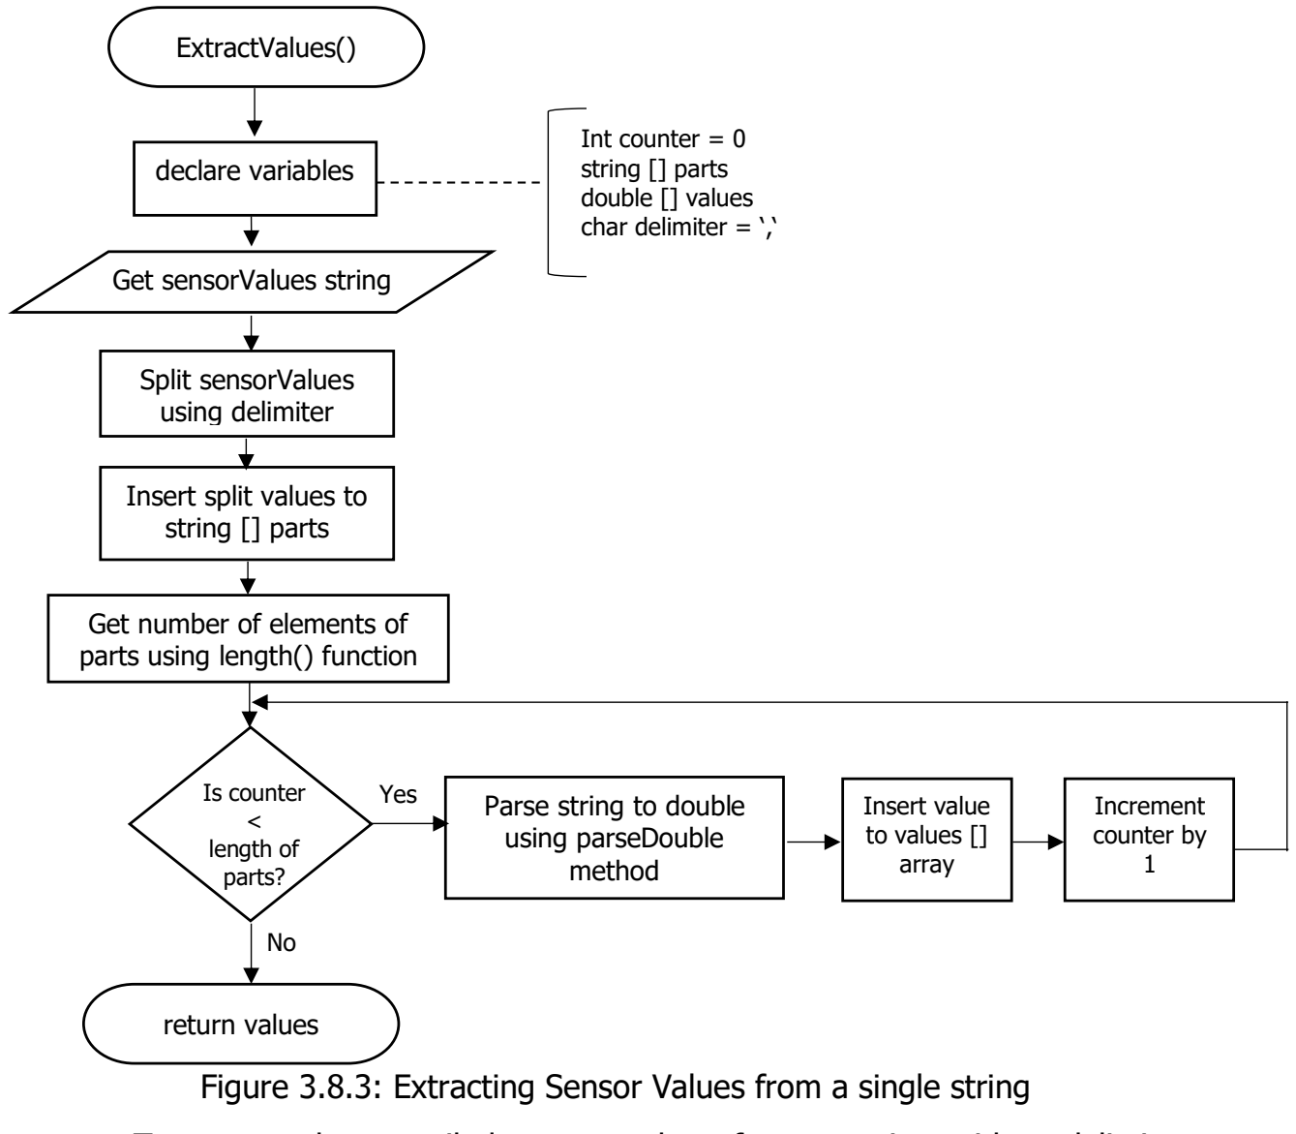
[picture p30: figure]
ExtractValues(); Get sensorValues string; declare variables; Split sensorValues using delimiter; Get number of elements of parts using length() function; Insert split values to string [] parts; Is counter < length of parts?; Parse string to double using parseDouble method; Increment counter by 1; Yes; return values; Insert value to values [] array; Int counter = 0 string [] parts double [] values char delimiter = ‘,‘

To extract the compiled sensor values from a string with a delimiter,

Figure 3.8.3 will be implemented. The string will be split using a delimiter of ‘,‘,

## the split parts will then be placed to an array named string [] parts that will

## contain all of the sensor values but with a string data type, to be able to process

## this data it needs to be converted to a double data type. The length of the string

## [] parts array, each element of this array will be parsed to double and will be

placed in a new array named double [] values array.

## Figure 3.8.3: Extracting Sensor Values from a single string

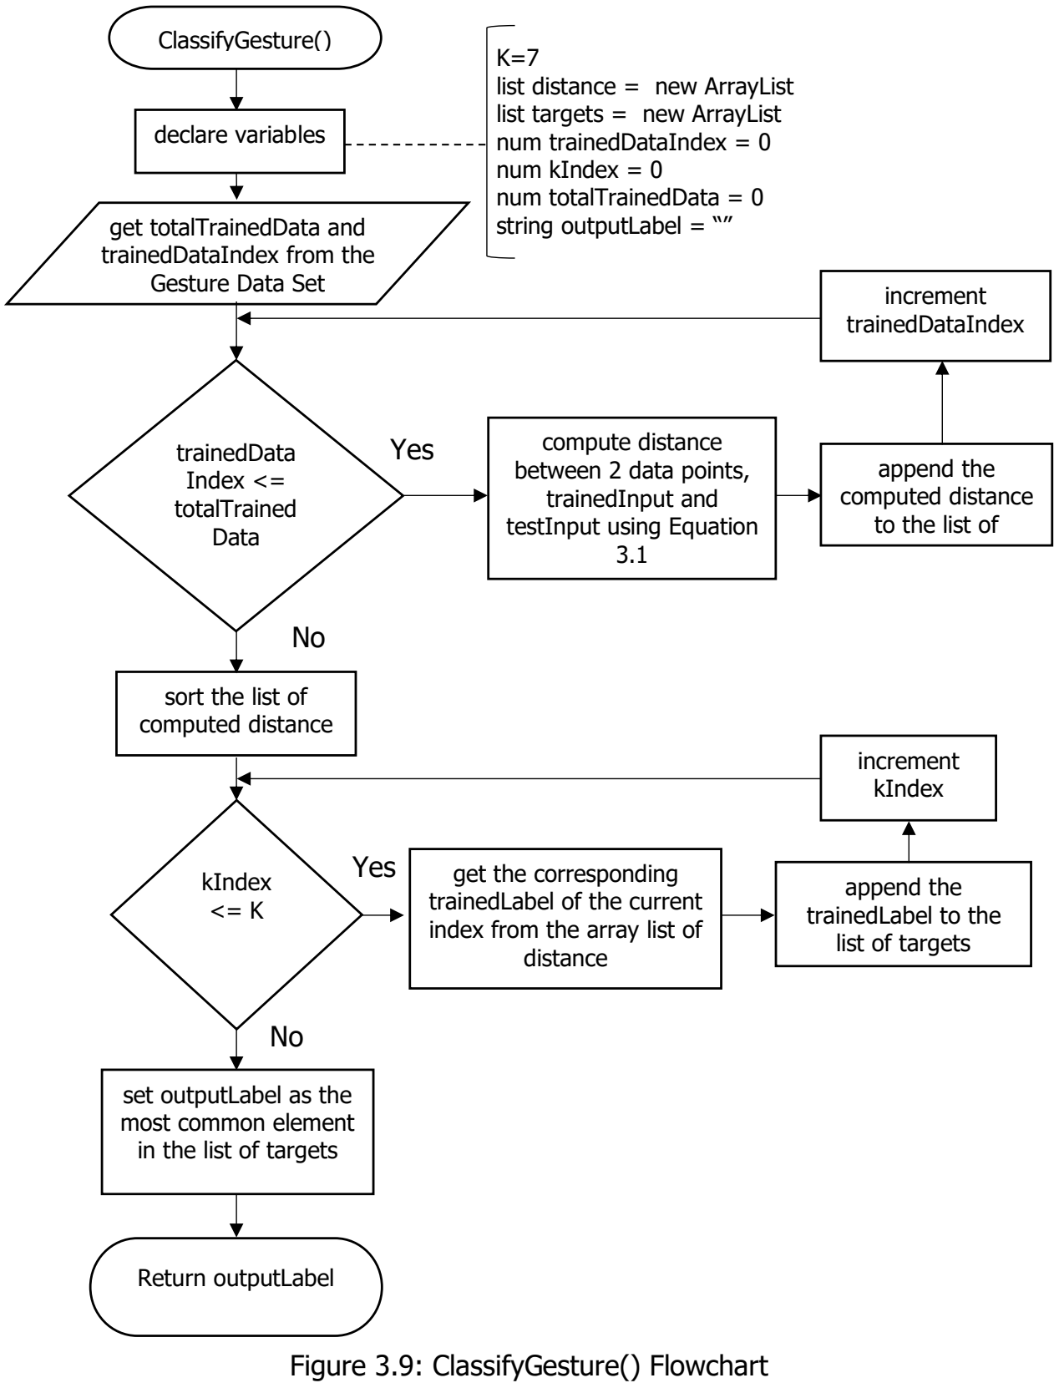
[picture p31: figure]
sort the list of computed distance; get the corresponding trainedLabel of the current index from the array list of distance; append the trainedLabel to the list of targets; increment kIndex; Return outputLabel; kIndex <= K; set outputLabel as the most common element in the list of targets; Yes; get totalTrainedData and trainedDataIndex from the Gesture Data Set; K=7 list distance = new ArrayList list targets = new ArrayList num trainedDataIndex = 0 num kIndex = 0 num totalTrainedData = 0 string outputLabel = “”; ClassifyGesture(); declare variables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

## Figure 3.9 ClassifyGesture() Flowchart Figure 3.9: ClassifyGesture() Flowchart

## Preparing the Software to be used

## In writing the program and creating the installer for the android

## application, the Android Studio will be used. This is the official IDE for android

development, and it uses Java as its main programming language.

## Training Application Development

## Needs of the Program that must be satisfied

## A training application is needed to create a dataset that will be used in the

## android application. The training application should be able to receive sensor

## data from the microcontroller of the gloves and classify it to a specific label using

## the K-Nearest Neighbor (KNN). Since KNN is a supervised learning algorithm, the

## training application should be able to ask the user if the classification is correct

or not. In this way, every time the classification is wrong, it could be corrected.

## Lastly, when the user responds if the classification is correct or not, the

## application should be able to collect the received sensor data and add the proper

label with it.

## System Flowchart

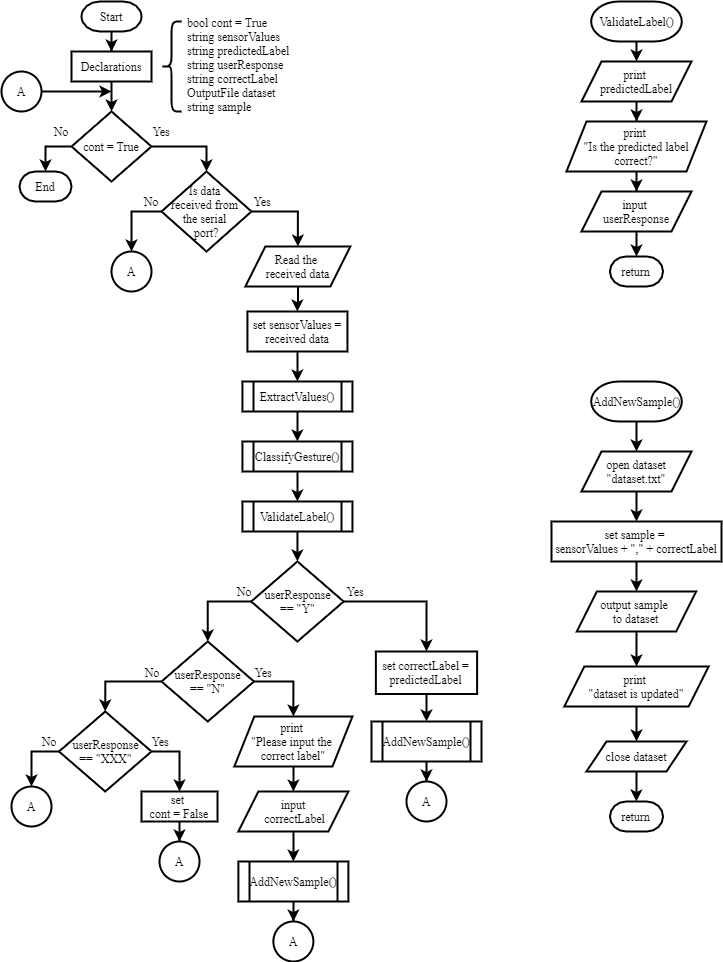
[picture p32: figure]

## Figure 3.10: System Flowchart for Training Application

## Figure 3.10 shows the flowchart to be followed in developing the training

application. All variables to be used are declared at the start of the program.

From here, the program will loop while the bool variable cont is set to true.

## Inside the loop, the program will check whether there is data received from the

## gloves via Bluetooth through the serial port. If data is received, the data will be

## set to a variable and will be used in the ExtractValues module, which can be

## seen in Figure 3.8.3, to get each sensor's values. The extracted sensor values

will then be used in the ClassifyGesture module, which can be seen in Figure 3.9,

## to get the predicted label using K-Nearest Neighbors (KNN). Once the predicted

## label is acquired, it will then be validated by the user before it will be saved in

## the dataset. If the user input is “Y”, the user implies that the predicted label is

## correct and the AddNewSample module will be used to save the sensor values

## and its corresponding label in the dataset. If the user input is “N”, the user

## implies that the label is wrong and will then be asked for the correct label and

## the AddNewSample module will be called. If the user input is “XXX”, the bool

variable will be set to false and the program will end.

## Preparing the Software to be used

## A simple Python script will be created and will be used to create the

## dataset for the K-Nearest Neighbor algorithm. The chosen IDE to be used is

PyCharm, as it is mainly used for Python programming language.

## D. Prototype Development

## Step-by-Step Procedure of Prototype Development

1. Identify the needs of the prototype that must be satisfied.
2. Upload the code to the ATmega328P.

## 3. Plan the layout and design of the PCB of the main module and the

charging module of the prototype.

## 4. Prepare the components to be used according to the schematic diagram

of the prototype.

5. Develop the PCB and solder the components in their proper location.
6. Plan and create the casing for the prototype.
7. Place and secure the PCB on the casing created.

## 8. Test the Prototype

## The step by step procedure above shows the process for the development

## of the prototype. First, the needs of the prototype is identified. Then, the created

code that will collect all sensor values will be uploaded to the ATmega328p.

## Then, the development of the PCB will be based on the materials that were used

## in the schematic diagram. After the PCB has been developed and all components

## are placed, the casing will then be created to protect all the components. The

## final step in the prototype development is to test it after all the components are

in place and secured inside the casing.

## a. PCB Design

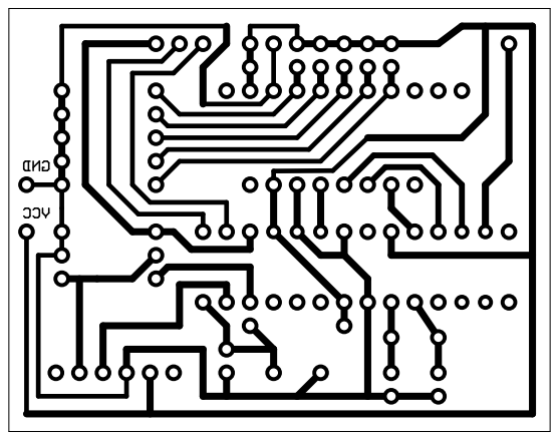
[picture p33: figure]

## Figure 3.11: Main Module PCB Design

Figure 3.11 Illustrates the PCB design that was used for the main module.

This module contains all the sensors that will send data to the mobile application.

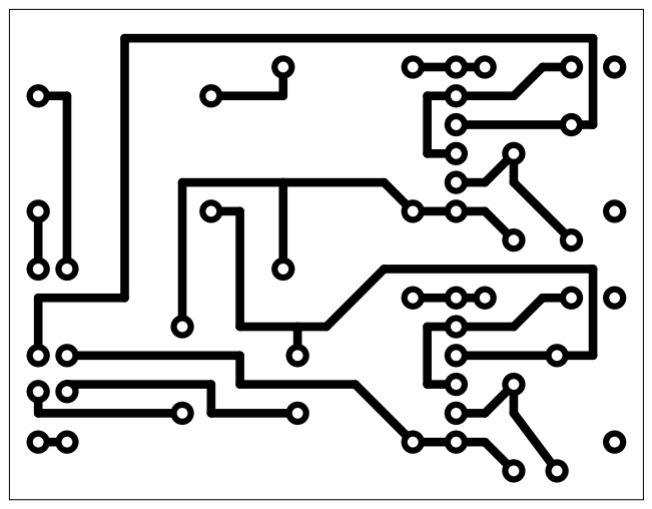
[picture p34: figure]

## Figure 3.12: Battery Module PCB Design

## Figure 3.12 shows the PCB design for the battery module. This module

will be responsible for powering and charging the system.

## b. PCB Component Diagram

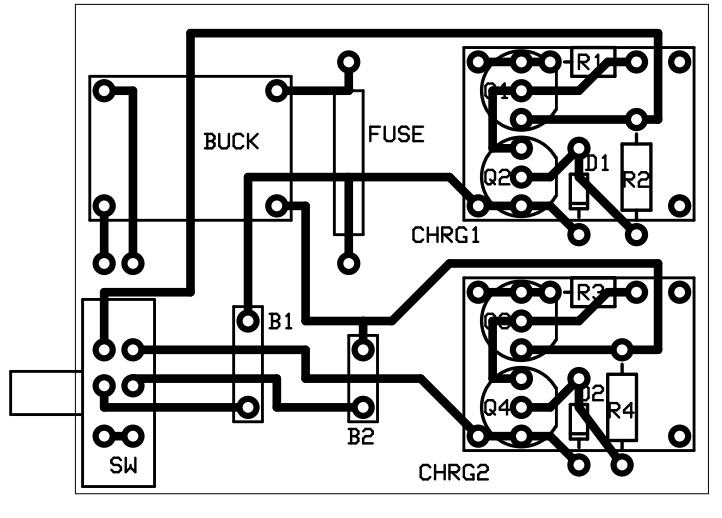
[picture p35: figure]

## Figure 3.13: Main Module PCB Component Diagram

## Figure 3.13 Illustrates the PCB component diagram that was used for the

## main module. This figure shows the placement of all the sensors and other

components on the PCB.

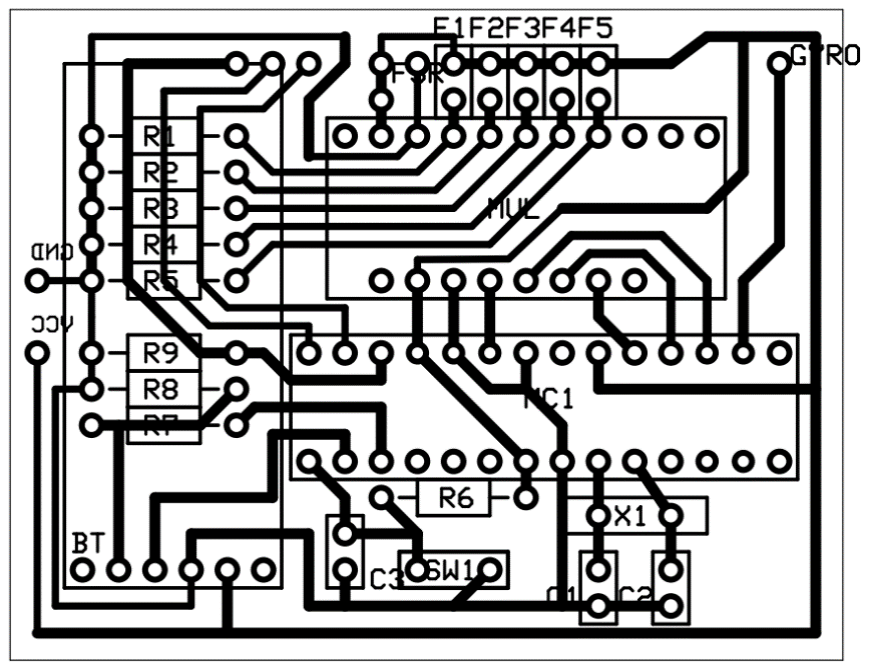
[picture p36: figure]

## Figure 3.14: Battery Module PCB Component Diagram

Figure 3.14 shows the PCB component diagram for the battery module.

This figure shows which components are soldered on the holes of the PCB.

## c. Casing Model of the Prototype

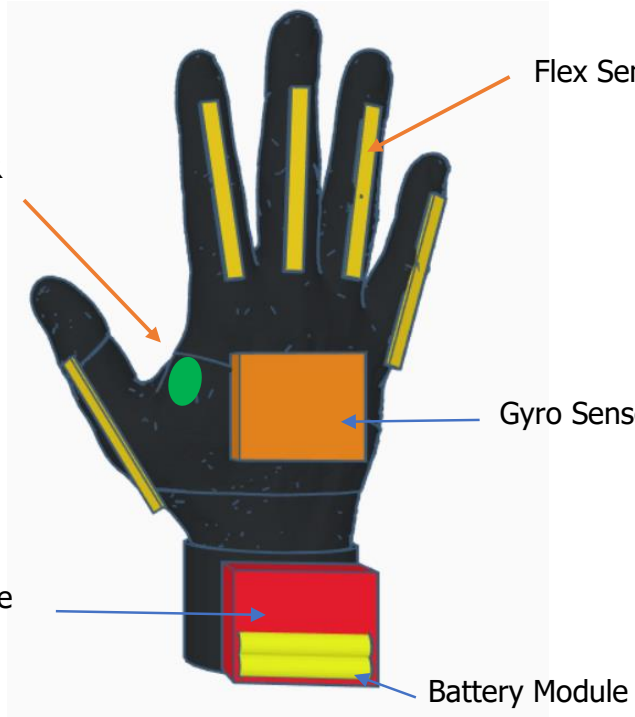
[picture p37: figure]
Battery Module

## Figure 3.15: Components used in the Prototype

## Figure 3.15 shows the casing for the components. The main module is

## composed of the components namely the ATmega328p and the Bluetooth

## module, the battery module which is made up of the TP4056 as well as the

## battery will be contained in a compact case will be placed in a case along the top

## of the wrist. The flex sensors will be placed on top of the fingers. The force-

## sensitive resistor is placed on the thenar space while the gyro sensor is placed on

the back of the hand.

## Gyro Sensor

## FSR

## Flex Sensor

## Main Module

## d. Bill of Materials

## Table 3.1: Tabulated Bill of Materials

Material | Price (Php) | Quantity | Total (Php)
ATMega328P | 126.00 | 1 | 126.00
Flex Sensor (4.5”) | 999.75 | 3 | 2999.25
Flex Sensor (2.2”) | 549.75 | 2 | 1099.5
14500 Li-Ion Battery | 79.75 | 2 | 159.5
Force Sensitive Resistor | 450.00 | 1 | 450.00
MPU6050 | 169.75 | 1 | 169.75
HC05 BT Module | 299.75 | 1 | 299.75
TP4056 | 39.75 | 2 | 79.50
DPDT Switch | 12.00 | 1 | 12.00
Fuse | 10.00 | 1 | 10.00
Buck Converter Step Down Module | 79.75 | 1 | 79.75
PCB (4x6) | 50.00 | 1 | 50.00
74HC4051 Multiplexer | 99.75 | 1 | 99.75
Battery Holder | 15.00 | 1 | 15.00
| | Grand Total | Php 5,649.75

Table 3.1 shows the list of materials and its corresponding price and quantity.

The grand total for the equipment costs Php 5,649.75.

## E. Multiple Design Constraints

## Table 3.2: Decision Matrix of Design Constraints

## Decision Evaluation Criteria

Weight | Portability | Operation Time | Accuracy | Total
| 0.3 | 0.2 | 0.5 | 1
| Score | Total Weight | Score | Total Weight | Score | Total Weight
Ergonomics | 5 | 1.5 | 3 | 0.6 | 3 | 1.5 | 3.6
Accessibility | 3 | 0.9 | 3 | 0.6 | 1 | 0.5 | 2
Safety | 3 | 0.9 | 1 | 0.2 | 1 | 0.5 | 1.6
Constructability | 4 | 1.2 | 0 | 0 | 0 | 0 | 1.2
Usability | 3 | 0.9 | 4 | 0.8 | 5 | 2.5 | 4.2
Sustainability | 4 | 1.2 | 3 | 0.6 | 1 | 0.5 | 2.3

## The scores for the multiple design constraints will be from 1 to 5, 1 being

## the lowest and 5 being the highest. There are multiple design constraints that

## the researchers have encountered, the most relevant of which are discussed

below.

## Usability

## The machine learning algorithm that is used in performing the translation

## of sign language to text makes extensive use of computing power. A computer

## or a laptop could be used to perform computations. Another alternative would be

## to use an Android phone in the translation, but its computing power is sub-par

compared to a computer.

## Sustainability

## The battery life of a Lithium-Ion based battery decreases performance

## overtime. An alternative would be to use a power cord; its usability is longer

compared to a rechargeable battery.

## Ergonomics

## In transferring the data from the microcontroller to the computing device

## that will be used, a data cable from the microcontroller could be connected to

## the computing device. An alternative would be to make use of a Bluetooth

connection between the two devices.

## F. Trade-offs

## Machine learning needs large amounts of memory to perform its tasks, a

## computer or a laptop is the most suitable platform to use since it has the power

to perform computations even with a large data set, but it lacks the portability.

## On the other hand, an Android phone has less computing power compared to a

computer or a laptop but offers great portability since it is a handheld device.

## In implementing the design, either Li-Ion batteries or a simple power cord

## connection can be used to power the device. On one hand, the Li-Ion batteries’

## performance degrades depending on how many times it has been used, but it

## offers great portability for the device. On the other hand, a simple power cord

## connecting the device would give the device more time for usability, since it

provides continuous power, and its life doesn’t degrade with each use.

## Using a data cable is viable in transferring data from the microcontroller to

## the Android phone; its transfer speed is faster compared to Bluetooth, but at the

## cost of the device’s ergonomics since the microcontroller is on the glove, it would

## be difficult to perform some of the gestures while the user is tied down to the

## phone. Bluetooth, on the other hand, has a slower transfer speed but it does not

## use any wire to connect to the phone giving the user more freedom for the

movement of their hand.

## G. Selection of Alternative Solution

## The scores for the decision matrix will be from 1 to 5, 1 being the lowest

and 5 being the highest.

## Table 3.3: Decision Matrix for Usability Constraint

Usability | Weight | Alternative Solution
A computer for performing computations | Android phone in the translation
Score | Weighted Score | Score | Weighted Score
Reliability | 0.3 | 5 | 1.5 | 4 | 1.2
Portability | 0.7 | 2 | 1.4 | 5 | 3.5
Total Weighted Score | | 2.9 | | 4.7

## Table 3.3 shows the decision matrix for the usability constraint. This

## constraint is about the capability of the system in terms of providing portability

## while being used, as well as providing reliable results while using the device. Two

## solutions were formulated, one is the use of a computer in performing

## computation and another is the use of an android device. Both devices are

## capable of performing the K-Nearest Neighbor Algorithm, but the computer will

## outperform the android device in terms of raw performance. Since one of the

## objectives that are supposed to be met is the portability of the device, the

## Android phone was decided to be used in the solution. It may not have the same

## computing power as a computer or a laptop, but it still has sufficient memory to

translate the sign language to text.

## Table 3.4: Decision Matrix for Sustainability Constraint

Sustainability | Weight | Alternative Solution
Lithium-Ion based battery | Power Cord
Score | Weighted Score | Score | Weighted Score
Portability | 0.6 | 5 | 3 | 3 | 1.8
Reliability | 0.4 | 3 | 1.2 | 4 | 1.6
Total Weighted Score | | 4.2 | | 3.4

## Table 3.4 shows the decision matrix for the sustainability constraint. This

## constraint is all about how long the device can be used while giving out good

## results in terms of gesture classification while maintaining its portability. There

## were two alternatives formulated, this is through the use of a Lithium-Ion based

## battery and another is through the use of a power cord to provide power to the

## system. The use of a power cord will give a more stable power source for the

## system but since one of the objectives is to make the device portable, the

## Lithium-Ion based battery was selected, that is why a charging module was then

added to make the device last longer. Again on the portability of the device,

## using a Li-Ion battery would enable the user to use the device anywhere, unlike

## the power cable where the user needs to plug into a socket, it would also need a

power brick to lower the voltage, and to convert AC to DC coming from a socket,

## it will also hinder the user to do hand gestures freely because of the dangling

power cord that is connected to the power supply.

## Table 3.5: Decision Matrix for Ergonomics Constraint

Ergonomics | Weight | Alternative Solution
Use of a data cable from the microcontroller | Use of a Bluetooth connection
Score | Weighted Score | Score | Weighted Score
Reliability | 0.5 | 5 | 2.5 | 4 | 2
Convenience | 0.5 | 2 | 1 | 4 | 2
Total Weighted Score | | 3.5 | | 4

## Table 3.5 shows the decision matrix for the ergonomics constraint. This

## constraint is about the convenience and the reliability of data transmission from

## the gloves to the computing device which is the android phone. Two solutions

## were formulated, first is the use of a data cable that will connect to the android

## device for data transmission and another is the use of a Bluetooth connection for

wireless data transmission. In considering the ergonomics of the device,

## Bluetooth is the alternative that is used, with the use of Bluetooth, no wire will

## impede the user in making their hand gesture. The use of a wireless Bluetooth

## connection will free up the movements the users can take unlike with the data

## cable, the user should be mindful of their hand’s movements because the wire

may be tangled up.

## H. Impact of Design Solution

## The design will impact the livelihood of the deaf and their relatives. It can

be very hard for a person to not understand what the other person is saying,

what more when you can’t communicate entirely. With the help of the device,

## more people will be able to communicate with the deaf directly by starting to

## learn sign language. Below is the impact of the design solution in different

categories.

## Global

## In 2018, there are 466 million people in the world who are experiencing a

## disabling hearing loss [11]. The design would help start people’s understanding

## of sign language. It will help newly deaf and their relatives to start learning the

language and ease their way into more advanced sign language.

## Societal

## Most of the families in the urban poor sector in the Philippines prefer to let

## their children without disabilities go to school instead of those with disabilities

## [8]. Having this device where they can train by themselves. It would lead to

## more deaf children getting the education that they deserve. By lowering the

## barrier to which people can learn Filipino Sign Language, more people will be

## able to understand the deaf. It would break the stigma of deaf people not having

the same capability to work as people without disabilities.

## Economic

## The design would also lead to the increase of employment for these

## people with disabilities, not only because more people with disabilities will have a

## chance of education, but also because more people will be able to understand

## sign language. Deaf people employed, especially in services, will have an easier

time interacting with people.

## Environmental

## The design is environmentally friendly, in which the power supply used is

## a rechargeable battery which is far less waste compared to non-rechargeable

ones that are binned after one usage.

## I. Engineering Principles

To build a device capable of translating Filipino Sign Language to text,

engineering principles were applied.

## Electrical

## Basic electrical principles were used to create the schematics of the

## device, and to determine the correct amount of power the device needs. The

## amount of voltage needed by the components of the device was determined

using the appropriate datasheets.

## Electronics

## Basic electronics principles are used to make the devices work properly. It

## is used in the interconnections of the components, and the knowledge about

## transistors is used especially in the charging circuit to prevent any damage to the

circuit in the event of placing the batteries incorrectly.

## Programming

## Programming is used in programming the microcontroller for it to be able

## to gather the values of the sensors and to send those values to the phone. It is

also used in creating the Android app for translating the gestures into text.

## J. Modern Engineering Tools

## Arduino IDE

## The Arduino IDE was used in programming the instructions for the

## ATmega328p IC. It is also used as a debugging tool to calibrate the sensors and

to see the values that the sensors are getting.

## Android Studio

## The Android Studio is used to develop the app where the translated text is

being displayed.

## PyCharm

PyCharm is an IDE that enables users to code using the Python Language.

It is used in developing the machine learning algorithm.

## Livewire

## Livewire is a software that provides the required tools to create the

schematic diagram of the device. It is also used in simulating the circuit.

## ExpressPCB

## ExpressPCB is a program that provides tools to create the PCB layout of

the main module and the charging module of the glove.

## Chapter 4

## TESTING, PRESENTATION, AND INTERPRETATION OF DATA

## A. Picking the K value

## It is important to pick the K-value to be used in the K-Nearest Neighbor

(KNN) algorithm since it determines the classification of the gesture.

## B. Purpose of the Test

## Picking the value of K that will be used for the K Nearest Neighbor

## algorithm is important as it affects the result of each classification. A small value

## of K will result in a noise having a large effect on the results, while a large value

of K will make it computationally expensive for the device it will be applied to.

## C. Initial Assumptions

## The initial assumptions for this test are that the optimal K value for the

## design is greater than 3, since that value is too small to give an accurate

classification, but is less than 11 since the dataset that is used is not very big,

## the data points that have similar gestures will have a greater impact to the

output.

## D. Procedures in picking the K Value

## To pick the K value that will be used for the KNN, the following steps are

done.

## 1. A sample of sensor values from the gloves for each label was acquired

## through serial communication between the gloves and the computer using

PuTTY.

2. The samples were prepared by placing it on a text file.

## 3. The text file containing the samples was used as an input to a simple

## python script that uses K Nearest Neighbor classification using the created

dataset and applying different values of K.

## 4. The result of the classification is recorded and the score for each value of

K is counted.

5. There are 5 trials. Repeat steps 1 to 4 for each trial.

## E. Data Table for the value of K

## Table 4.1: Picking the value of K (Trial 1)

Label | Value of K
1 | 3 | 5 | 7 | 9 | 11 | 13 | 15 | 17 | 19
A | A | A | A | A | A | A | A | A | A | A
B | B | B | B | B | B | B | B | B | B | B
C | C | C | C | C | C | C | C | C | C | Y
D | L | L | L | L | L | L | L | L | D | L
E | E | E | E | E | E | E | M | M | M | M
F | F | F | F | F | F | F | F | F | F | F
G | G | G | G | G | G | G | G | G | G | G
H | U | U | U | U | U | U | U | U | U | U
I | I | I | I | I | I | I | I | I | I | I
J | J | J | J | J | J | J | J | J | J | J
K | U | U | U | U | U | U | U | U | U | U
L | L | L | L | L | L | L | L | L | L | L
M | M | M | M | M | M | M | M | M | M | M
N | N | N | N | N | N | N | N | N | N | N
O | O | O | O | O | O | O | O | O | O | O
P | P | P | P | P | H | H | H | H | H | H
Q | Q | Q | Q | Q | Q | Q | Q | Q | Q | Q
R | R | R | R | R | R | R | R | R | R | R
S | S | S | S | S | S | S | S | S | S | S
T | X | T | N | A | A | T | T | T | A | A
U | U | U | U | U | U | U | U | U | U | U
V | V | V | V | V | V | V | V | V | V | V
W | W | W | W | W | W | W | W | W | W | W
X | X | X | X | X | T | X | X | X | A | A
Y | Y | Y | Y | Y | Y | Y | Y | Y | Y | Y
Z | Z | Z | Z | Z | Z | Z | Z | Z | Z | Z
Space | __ | __ | __ | __ | __ | __ | __ | __ | __ | __
Score | 23/27 | 24/27 | 23/27 | 23/27 | 21/27 | 23/27 | 22/27 | 22/27 | 21/27 | 20/27

## Table 4.2: Picking the value of K (Trial 2)

Label | Value of K
1 | 3 | 5 | 7 | 9 | 11 | 13 | 15 | 17 | 19
A | A | A | A | A | A | A | A | A | A | A
B | B | B | B | B | B | B | B | B | B | B
C | O | C | C | C | C | C | C | C | C | C
D | D | D | D | D | D | D | D | D | D | D
E | E | E | M | M | M | M | M | M | M | M
F | F | F | F | F | F | F | F | F | F | F
G | G | G | G | G | G | G | G | G | G | G
H | H | H | H | H | H | H | H | H | H | H
I | I | I | I | I | I | I | I | I | I | I
J | I | I | I | I | I | I | I | I | I | I
K | K | K | K | K | K | K | K | K | K | K
L | L | L | L | L | L | L | L | L | L | L
M | M | M | M | M | M | M | M | M | M | M
N | N | N | N | N | N | N | N | N | N | N
O | O | O | O | O | O | O | O | O | O | O
P | P | P | P | P | P | P | P | P | P | P
Q | Q | Q | Q | Q | Q | Q | Q | Q | Q | Q
R | R | R | K | R | R | R | R | R | R | R
S | S | S | S | S | S | S | S | S | S | S
T | T | T | T | T | T | T | T | T | T | T
U | U | U | U | U | U | U | U | U | U | U
V | V | M | M | M | V | V | V | V | V | V
W | W | W | W | W | W | W | W | W | W | W
X | T | T | T | T | T | T | T | T | T | T
Y | Y | Y | Y | Y | Y | Y | Y | Y | Y | Y
Z | Z | Z | Z | Z | T | T | T | T | T | T
Space | __ | __ | __ | __ | __ | __ | __ | __ | __ | __
Score | 24/27 | 24/27 | 22/27 | 23/27 | 23/27 | 23/27 | 23/27 | 23/27 | 23/27 | 23/27

## Table 4.3: Picking the value of K (Trial 3)

Label | Value of K
1 | 3 | 5 | 7 | 9 | 11 | 13 | 15 | 17 | 19
A | A | A | A | A | A | A | A | A | A | A
B | B | B | B | B | B | B | B | B | B | B
C | C | C | C | C | C | C | C | C | C | C
D | D | D | D | D | D | D | D | D | D | D
E | E | E | E | E | E | M | M | M | M | M
F | F | F | F | F | F | F | F | F | F | F
G | G | G | G | G | G | G | G | G | G | G
H | H | H | H | H | H | H | H | H | H | H
I | I | I | I | I | I | I | I | I | I | I
J | J | I | I | I | I | I | I | I | I | I
K | U | K | U | K | K | U | K | K | U | K
L | L | L | L | L | L | L | L | L | L | L
M | M | M | M | M | M | M | M | M | M | M
N | N | N | N | N | N | N | N | N | N | N
O | O | O | O | O | O | O | O | O | O | O
P | P | P | P | P | P | P | P | P | P | P
Q | Q | Q | Q | Q | Q | Q | Q | Q | Q | Q
R | U | R | R | R | U | U | R | R | U | U
S | S | S | S | S | S | S | S | S | S | S
T | X | T | T | T | T | T | T | T | T | T
U | U | U | U | U | U | U | U | U | U | U
V | V | V | V | V | V | V | V | V | V | V
W | W | W | W | W | W | W | W | W | W | W
X | T | X | X | X | X | X | X | X | X | X
Y | Y | Y | Y | Y | Y | Y | Y | Y | Y | Y
Z | Z | Z | T | Z | T | T | T | T | T | T
Space | __ | __ | __ | __ | __ | __ | __ | __ | __ | __
Score | 23/27 | 26/27 | 24/27 | 26/27 | 24/27 | 22/27 | 24/27 | 24/27 | 22/27 | 23/27

## Table 4.4: Picking the value of K (Trial 4)

Label | Value of K
1 | 3 | 5 | 7 | 9 | 11 | 13 | 15 | 17 | 19
A | A | A | A | A | A | A | A | A | A | A
B | B | B | B | B | B | B | B | B | B | B
C | C | C | C | C | C | C | C | C | O | O
D | D | D | D | D | D | D | D | D | D | D
E | E | E | E | E | E | E | E | E | M | M
F | F | F | F | F | F | F | F | F | F | F
G | G | G | G | G | G | G | G | G | G | G
H | H | H | H | H | H | H | H | H | H | H
I | I | I | I | I | I | I | I | I | I | I
J | I | I | I | I | I | I | I | I | I | I
K | U | U | U | U | U | U | U | K | K | K
L | L | L | L | L | L | L | L | L | L | L
M | M | M | M | M | M | M | M | M | M | M
N | N | N | N | N | N | N | N | N | N | N
O | O | O | O | O | C | O | C | C | C | C
P | P | P | P | P | P | P | P | P | P | P
Q | Q | Q | Q | Q | Q | Q | Q | Q | Q | Q
R | R | K | K | K | K | K | K | K | K | K
S | S | S | S | S | S | S | S | S | S | S
T | X | X | X | X | X | X | X | X | X | X
U | U | U | U | U | U | U | U | U | U | U
V | V | V | V | V | V | V | V | V | V | V
W | W | W | W | W | W | W | W | W | W | W
X | X | X | X | X | X | X | X | X | X | X
Y | Y | Y | Y | Y | Y | Y | Y | Y | Y | Y
Z | Z | Z | Z | Z | Z | Z | Z | Z | Z | Z
Space | __ | __ | __ | __ | __ | __ | __ | __ | __ | __
Score | 24/27 | 23/27 | 23/27 | 23/27 | 22/27 | 23/27 | 22/27 | 23/27 | 21/27 | 21/27

## Table 4.5: Picking the value of K (Trial 5)

Label | Value of K
1 | 3 | 5 | 7 | 9 | 11 | 13 | 15 | 17 | 19
A | A | A | A | A | A | A | A | A | A | A
B | B | B | B | B | B | B | B | B | B | B
C | C | C | C | C | C | C | C | C | C | Y
D | D | D | D | D | D | D | D | D | D | D
E | E | E | M | M | M | M | M | M | M | M
F | F | F | F | F | F | F | F | F | F | F
G | G | G | G | G | G | G | G | G | G | G
H | H | H | H | H | H | H | H | H | H | H
I | I | I | I | I | I | I | I | I | I | I
J | J | J | J | J | J | J | J | J | J | J
K | U | U | U | U | U | U | U | U | U | U
L | L | L | L | L | L | L | L | L | L | L
M | M | M | M | M | M | M | M | M | M | M
N | N | N | N | N | N | N | N | N | N | N
O | O | O | O | O | O | O | O | O | O | Y
P | P | P | P | P | P | H | H | H | H | H
Q | Q | Q | Q | Q | Q | Q | Q | Q | Q | Q
R | R | K | K | K | K | K | K | K | K | K
S | S | S | S | S | S | S | S | S | S | S
T | T | T | T | T | T | T | T | T | T | T
U | U | K | K | K | K | K | K | K | K | K
V | R | V | R | R | V | V | V | V | V | V
W | W | W | W | W | W | W | W | W | W | W
X | X | X | X | X | X | X | X | X | X | X
Y | Y | Y | Y | Y | Y | Y | Y | Y | Y | Y
Z | R | T | T | T | T | T | T | T | T | T
Space | __ | __ | __ | __ | __ | __ | __ | __ | __ | __
Score | 24/27 | 23/27 | 21/27 | 21/27 | 22/27 | 21/27 | 21/27 | 21/27 | 21/27 | 20/27

## Table 4.6: Picking the value of K (Summary of 5 Trials)

Trial | Value of K
1 | 3 | 5 | 7 | 9 | 11 | 13 | 15 | 17 | 19
1 | 23/27 | 24/27 | 23/27 | 23/27 | 21/27 | 23/27 | 22/27 | 22/27 | 21/27 | 20/27
2 | 24/27 | 24/27 | 22/27 | 23/27 | 23/27 | 23/27 | 23/27 | 23/27 | 23/27 | 23/27
3 | 23/27 | 26/27 | 24/27 | 26/27 | 24/27 | 22/27 | 24/27 | 24/27 | 22/27 | 23/27
4 | 24/27 | 23/27 | 23/27 | 23/27 | 22/27 | 23/27 | 22/27 | 23/27 | 21/27 | 21/27
5 | 24/27 | 23/27 | 21/27 | 21/27 | 22/27 | 21/27 | 21/27 | 21/27 | 21/27 | 20/27
Total | 118 | 120 | 113 | 116 | 112 | 112 | 112 | 113 | 108 | 107

## F. Analysis and interpretations of collected data

## The table shows that the K value of 3 gives the highest total of correct

## classification. However, a small value of K means that noise will have a higher

influence on the result. Thus, the K used for the KNN algorithm is 7.

## A. Testing the Android Application

## The application will be tested to measure its accuracy in translating FSL to

## text, this will be done by connecting the gloves to the created application to

## begin translating. The accuracy will be computed by dividing the number of

successful attempts to the total attempts multiplied by 100.

## B. Purpose of the Test

## This test will measure the accuracy of the system in translating Filipino

## sign language to text to determine how many times the gestures being

translated is correct with the use of the created android application.

## C. Procedures in Testing the Application

To test the functionality of the system, the following steps are done.

1. Install and open the application on an Android Phone.
2. Turn on the gloves and wear it properly.

## 3. Tap the gesture classification button on the android application and

connect to the gloves via Bluetooth.

## 4. Finger spell a letter and tap the Force Sensitive Resistor (FSR) for the

gloves to be able to send data to the application.

## 5. The label of the translated sign language will then be displayed to the

application.

## 6. If the displayed letter is the expected output, mark as a check, otherwise

cross it out. Repeat steps 4 to 6 until the column is filled.

## 7. There will be 10 trials, the number of successful attempts will be

## recorded, and the accuracy will be computed. This is shown in Table 4.7

## D. Initial Assumption

## The researchers assume that the application will be able to successfully

## translate the sign language to text when a letter does not require movement as

## its input. It can also have some difficulty in translating letters with almost the

same input such as I and J, S and T, and lastly U and V.

## E. Data Table for the Android Application

## Table 4:7: Android Application Testing

Label | Number of Successful Attempts | Number of Attempts | Accuracy (%)
A | 10 | 10 | 100
B | 10 | 10 | 100
C | 10 | 10 | 100
D | 9 | 10 | 90
E | 7 | 10 | 70
F | 10 | 10 | 100
G | 10 | 10 | 100
H | 9 | 10 | 90
I | 10 | 10 | 100
J | 6 | 10 | 60
K | 10 | 10 | 100
L | 10 | 10 | 100
M | 9 | 10 | 90
N | 10 | 10 | 100
O | 10 | 10 | 100
P | 10 | 10 | 100
Q | 10 | 10 | 100
R | 4 | 10 | 40
S | 9 | 10 | 90
T | 6 | 10 | 60
U | 9 | 10 | 90
V | 6 | 10 | 60
W | 10 | 10 | 100
X | 8 | 10 | 80
Y | 10 | 10 | 100
Z | 10 | 10 | 100
Space | 10 | 10 | 100

## F. Analysis and interpretations of collected data

## Based on the collected data, the system shows an average of 89.63%

## accuracy for translating FSL to text using the KNN algorithm. Most of the letters

in the alphabet have a 100% accuracy in translation except for D, E, H, J, M, R,

S, T, U, and X, with R having the lowest accuracy of 40%.

## Chapter 5

## CONCLUSION AND RECOMMENDATION

## Conclusion

## The design project of creating a Filipino Sign Language Translator was

## developed for the client which helps their operation by aiding them to

## understand FSL. The system uses a flex sensor, gyroscope, and accelerometer

## which are used to capture hand movements and gestures that are used to

## interpret a sign language gesture. To be portable, the researchers utilized the

## portability of an android device and created an application that is capable of

## translating Filipino Sign language (FSL) to text. The K-Nearest Neighbor falls in

## the family of supervised learning, a labeled dataset consisting of the sensor

## values alongside with the corresponding label was given to the model as its

## training data which was used to classify an input from the user, the system

## shows an average of 89.63% accuracy for translating FSL to text using the KNN

algorithm.

## Recommendation

## The prediction of the KNN algorithm is already acceptable; however, further

improvements of the system could be done through the use of the following.

## (1) The researchers recommend the use of a larger dataset for a better

prediction.

## (2) The researchers also recommend the collection of data with

different hand sizes for much better accuracy.

## Bibliography

## [1] Ada, L. (2015, November 19). Force Sensitive Resistor (FSR). Retrieved March 1, 2019, from https://learn.adafruit.com/force-sensitive-resistor-fsr/using-an-fsr

[2] Cloutier, P., Helderman, A., & Mehilli, R. (2016). Prototyping a Portable, Affordable Sign Language Glove.
[3] Esposa, J. I., Jr. (2017, August 05). Difference between ASL and FSL.

## Retrieved February 27, 2019, from https://deafphilippines.wordpress.com/2017/08/03/difference-between-asl-and-fsl

## [4] Girish, M. (2018, March 23). Bluetooth Basics: How to Control an LED Using an Android phone and Arduino. Retrieved March 1, 2019, from https://maker.pro/arduino/tutorial/bluetooth-basics-how-to-control-led-using-android phone-Arduino

## [5] Harrison, O. (2018, September 10). Machine Learning Basics with the K-

Nearest | Neighbors | Algorithm. | Retrieved | March | 5, | 2019, | from

## https://towardsdatascience.com/machine-learning-basics-with-the-k-nearest-neighbors-algorithm-6a6e71d01761

[6] Inquirer, P. D. (2016, November 6). In The Know: Sign languages.
Retrieved | February | 27, | 2019, | from

## https://newsinfo.inquirer.net/302184/in-the-know-sign-languages

[7] Lom, J. B. (2016). Flex Sensor Hookup Guide. Retrieved March 3, 2019,

## from https://learn.sparkfun.com/tutorials/flex-sensor-hookup-guide/all

[8] Mori, S. (2008). Economic Livelihood of the Deaf in the Philippines. Poverty Reduction for the Disabled in the Philippines, 159-164.
[9] Rosero-Montalvo, P. D., Godoy-Trujillo, P., Flores-Bosmediano, E.,

## Carrascal-Garcia, J., Otero-Potosi, S., Benitez-Pereira, H., & Peluffo-Ordonez, D. H. (2018). Sign Language Recognition Based on Intelligent Glove Using Machine Learning Techniques. 2018 IEEE Third Ecuador

Technical Chapters Meeting (ETCM).

[10] Sadam (2018, March 9). MPU6050 Gyro Sensor Interfacing with Arduino.

## Retrieved March 2, 2018, from https://circuitdigest.com/microcontroller-

projects/mpu6050-gyro-sensor-interfacing-with-arduino (https://circuitdigest.com/microcontroller-projects/mpu6050-gyro-sensor-interfacing-with-arduino)

## [11] World Health Organization (WHO). (2018, March 15). Deafness. Retrieved from World Health Organization: https://www.who.int/news-room/facts-

in-

## pictures/detail/deafness#:~:text=There%20are%20466%20million%20pe

ople,rise%20to%20over%20900%20million.

## Appendix

## A. Article

## B. Operation’s Manual

## 1. System Requirements

## Arduino IDE

- Microsoft Windows 7, Windows 8/8.1 and Windows 10 operating system.

## - Microsoft .NET Framework 4.0 or higher. (Download from Microsoft

## Webpage)

## - Intel Pentium / AMD Athlon processor or equivalent running at 1 GHz or

more.

- 512 MB RAM (1 GB RAM recommended).

## - 10MB free hard drive space or more (only for PROGRAMMING IDE for

Arduino).

## Android Studio

## - Microsoft® Windows® 7/8/10 (64-bit)

- 4 GB RAM minimum, 8 GB RAM recommended.

## - 2 GB of available disk space minimum, 4 GB Recommended (500 MB for

## IDE + 1.5 GB for Android SDK and emulator system image)

- 1280 x 800 minimum screen resolution.

## Android Application

## - Android Version:6.0.0 or above

## - Capable of using Bluetooth Connection

## 2. Installation Procedures for the Android Application

1. Download the Android Package (APK) file.
2. Allow installation for external sources.
3. Run and install the APK application.

## 3. User’s Manual

1. Enable Bluetooth connectivity of the Android Phone.
2. Open the Application.
3. Connect the Android Application to the device via Bluetooth.
4. Once connected the Device is ready to translate Sign Language to Text.

## 4. Troubleshooting Guides and Procedures

## The device won’t connect to the Application

1. Turn off the device and wait for at least 10 seconds.
2. Turn on the device.
3. Reconnect using the android application.

## C. Pictures of Prototype

## Side View

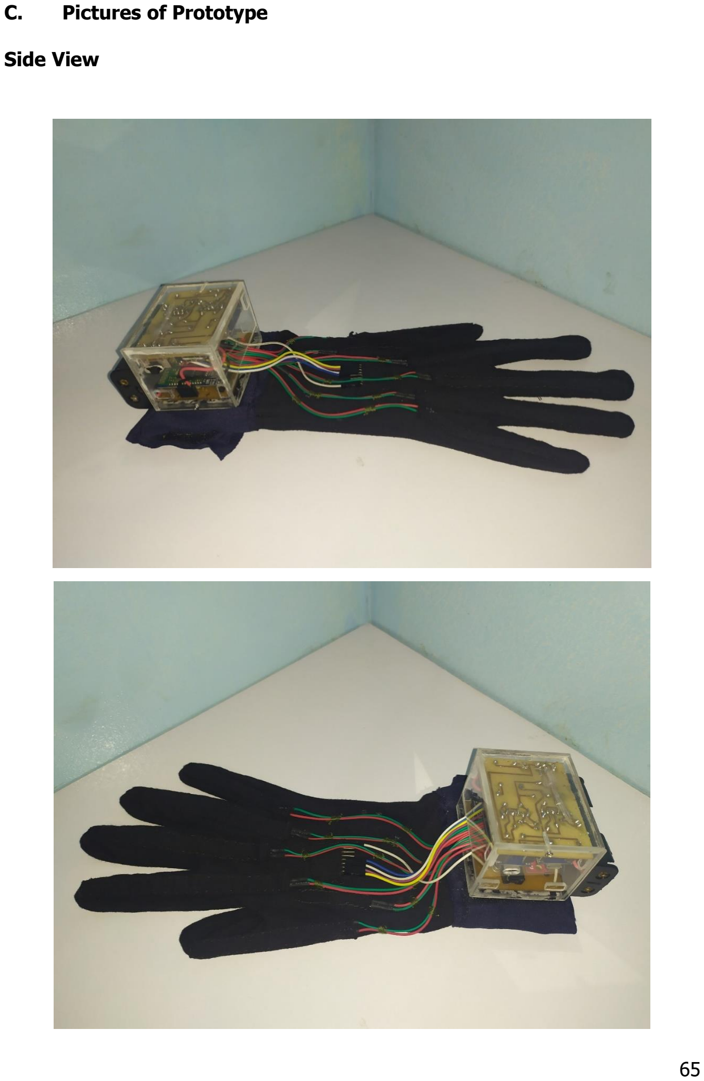
[picture p38: page 75]

## Top View

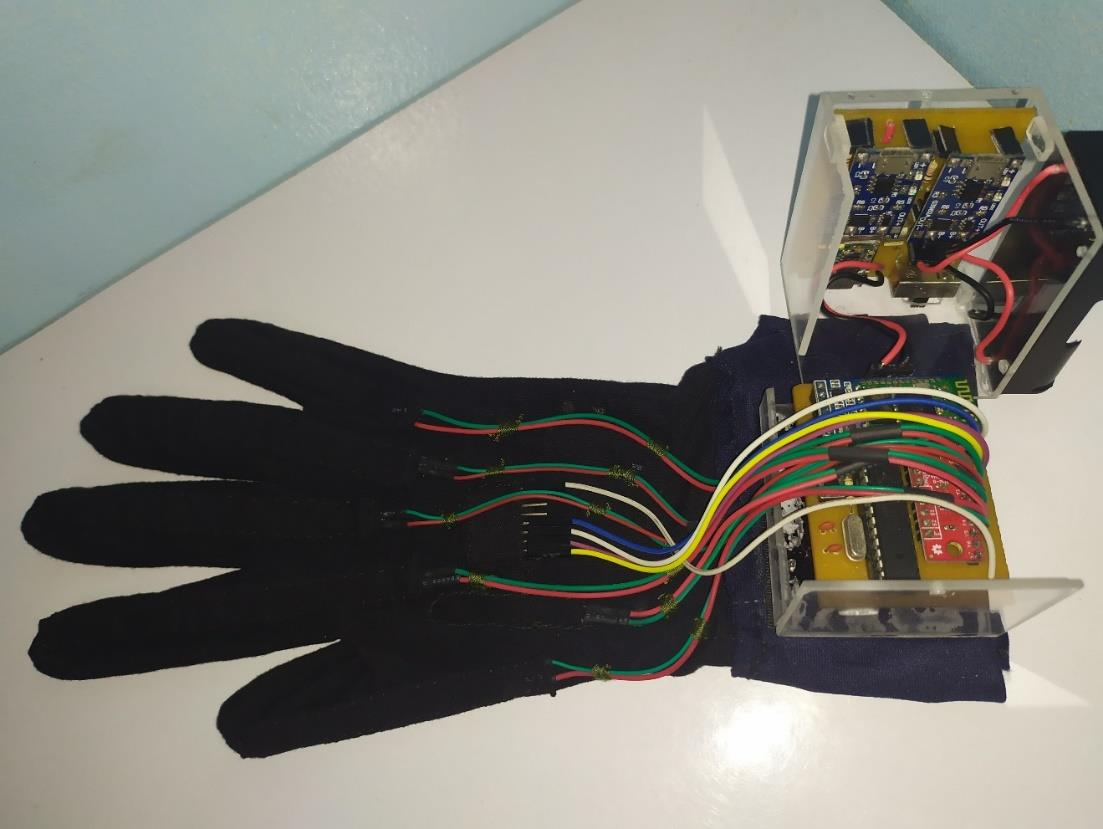
[picture p39: figure]

## D. Data Sheets

## ATMega328P

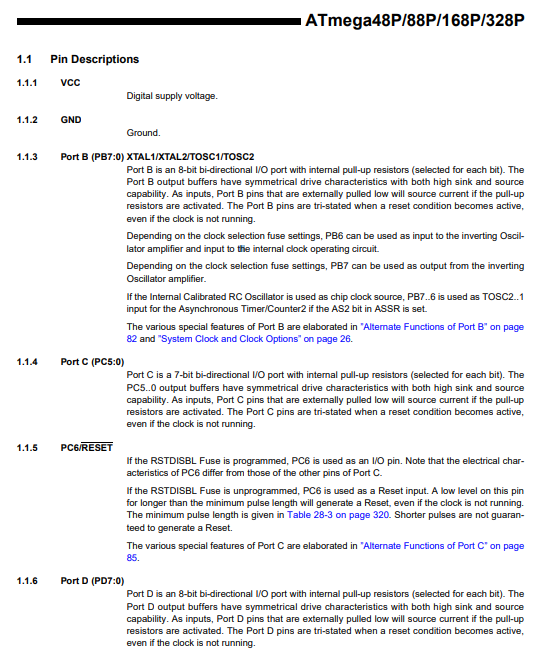
[picture p40: figure]

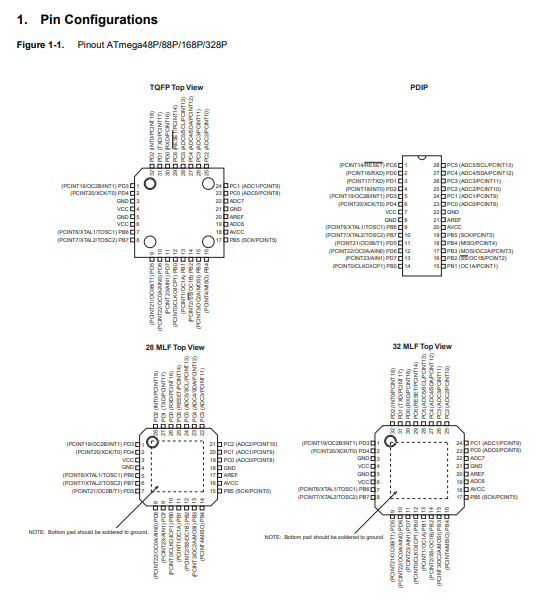
[picture p41: figure]

## Flex Sensor Data Sheet

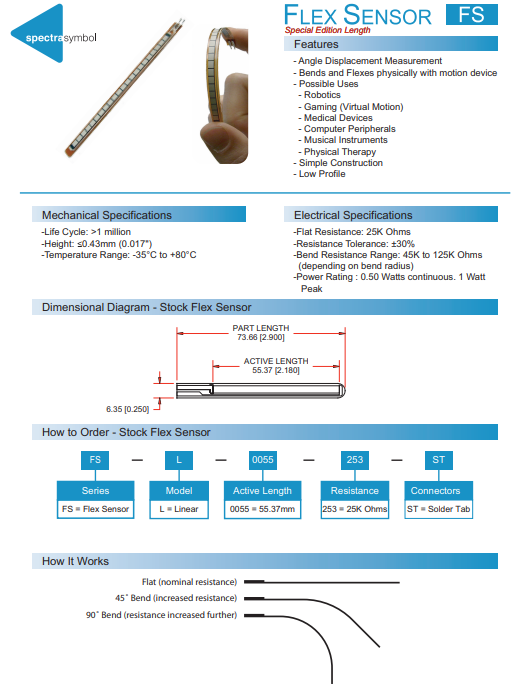
[picture p42: figure]

## 14500 Li-Ion battery Data Sheet

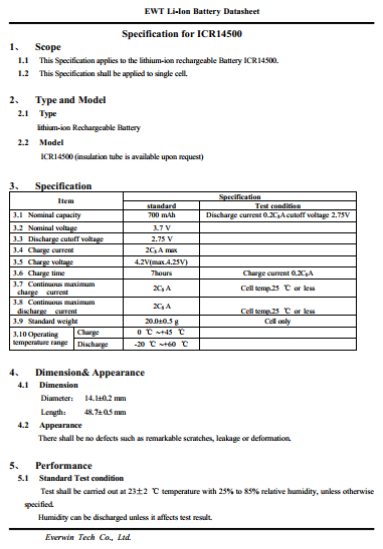
[picture p43: figure]

## FSR400 Data Sheet

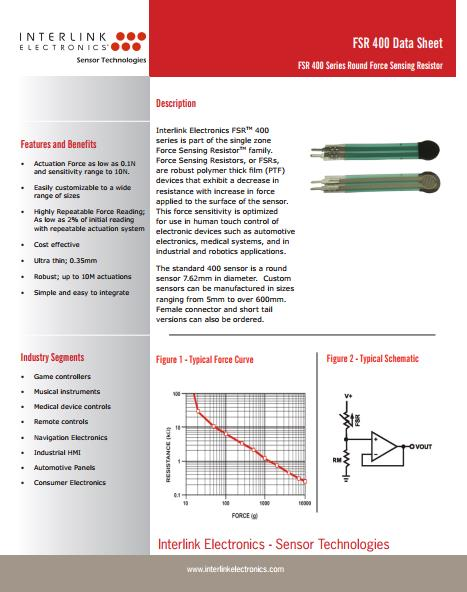
[picture p44: figure]

## HC05 Bluetooth Module

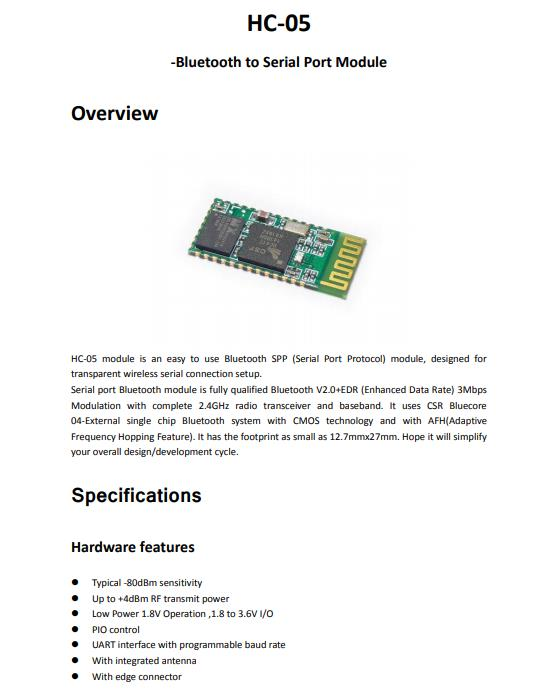
[picture p45: figure]

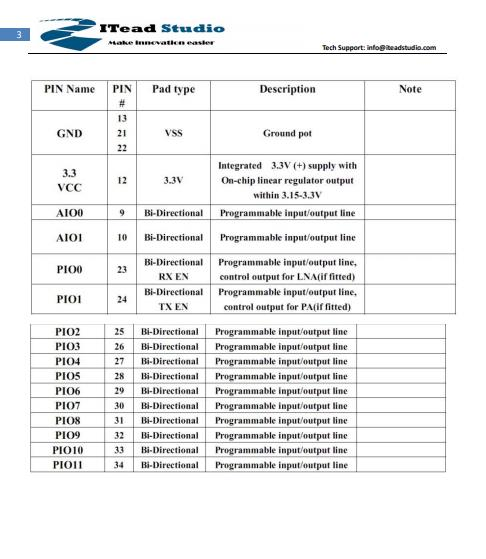
[picture p46: figure]

## TP4056 Data Sheet

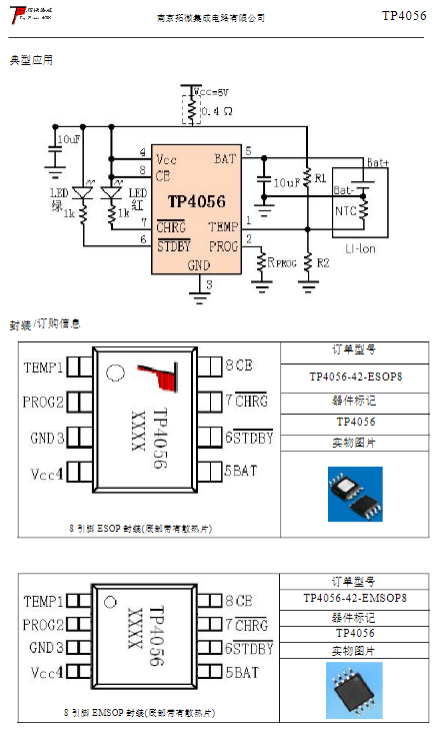
[picture p47: figure]

## E. Android Application

## Main Menu Activity Layout

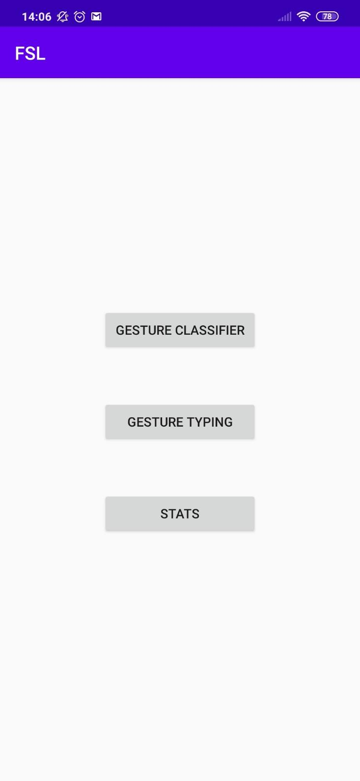
[picture p48: figure]

## Device Connectivity Layout

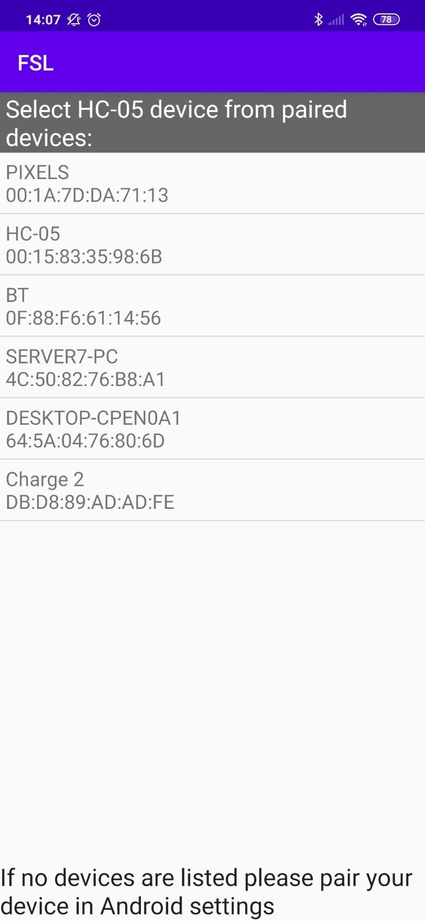
[picture p49: figure]

## Gesture Classification Activity Layout

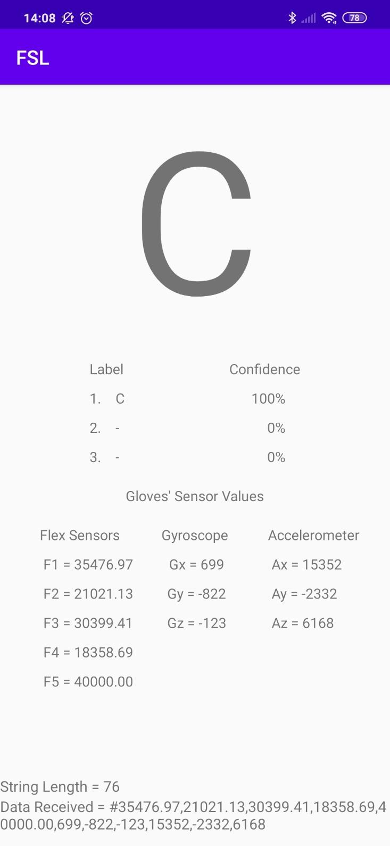
[picture p50: figure]

## Gesture Typing Activity Layout

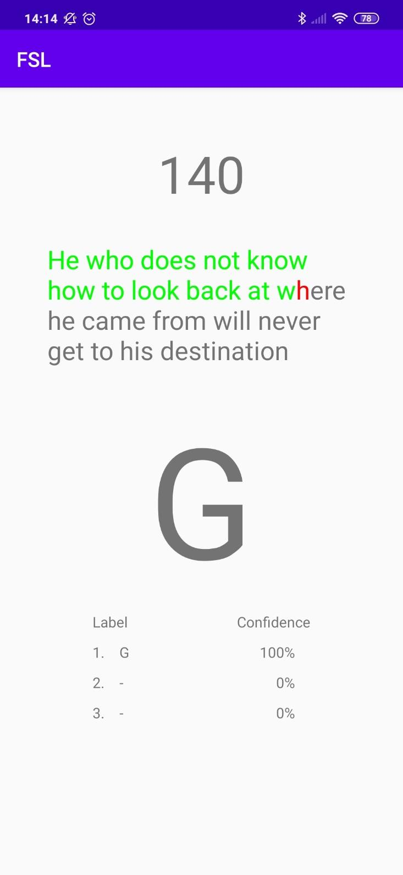
[picture p51: figure]

## Complete Dialog

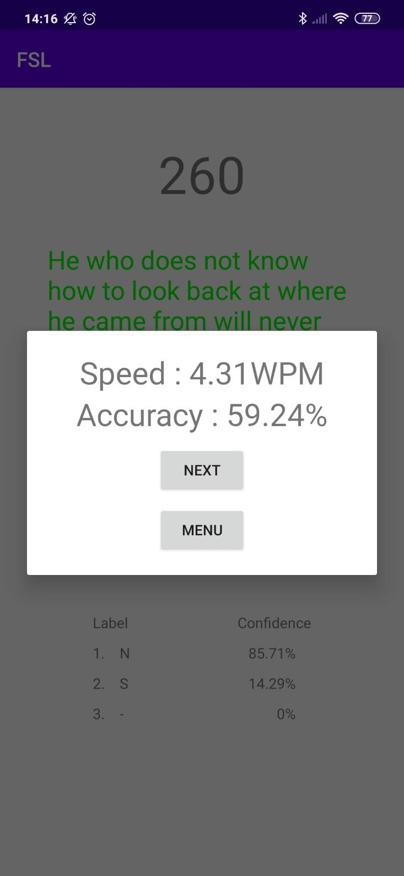
[picture p52: figure]

## Statistics Activity Layout

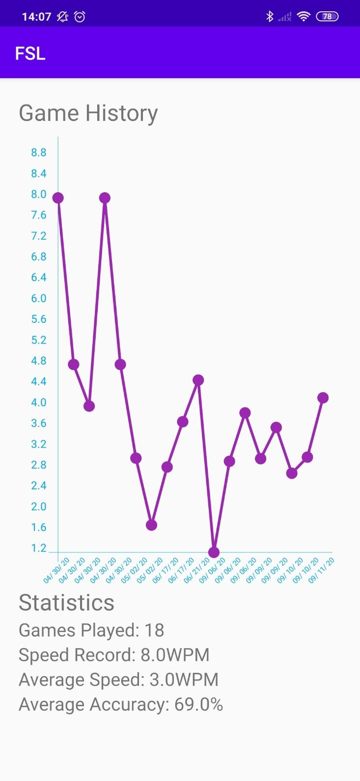
[picture p53: figure]

## MainMenu.java

import androidx.appcompat.app.AppCompatActivity; import android.content.Intent;
import android.os.Bundle;
import android.view.View;

public class MainMenu extends AppCompatActivity {

public static String KEY;

@Override
protected void onCreate(Bundle savedInstanceState) { super.onCreate(savedInstanceState); setContentView(R.layout.activity_main_menu);
}
/** Called when the user taps the GestureClassifying button */ public void gestureClassifer(View view) {
// Do something in response to button
Intent intent = new Intent(this, DeviceListActivity.class);

// Attach the key value pair using putExtra to this intent String key = "classify";
intent.putExtra(KEY, key);

// Starting the activity
startActivity(intent);
}

/** Called when the user taps the GestureTyping button */ public void gestureTyping(View view) {
// Creating and intializing Intent object
Intent intent = new Intent(this, DeviceListActivity.class);

// Attach the key value pair using putExtra to this intent String key= "type";
intent.putExtra(KEY, key);

// Starting the Activity
startActivity(intent);
}

/** Called when the user taps the ShowStats button */ public void showStats(View view) {
Intent intent = new Intent(this, StatsActivity.class); startActivity(intent);
}
}

## MainMenu.xml

<RelativeLayout xmlns:android="http://schemas.android.com/apk/res/android"xmlns:tools="http://schemas.android.com/tools"android:layout_width="match_parent"android:layout_height="match_parent"android:paddingBottom="@dimen/activity_vertical_margin"android:paddingLeft="@dimen/activity_horizontal_margin"android:paddingRight="@dimen/activity_horizontal_margin"android:paddingTop="@dimen/activity_vertical_margin" >

<Button
android:id="@+id/btn_gestureClassifier" android:layout_width="170dp" android:layout_height="wrap_content" android:layout_centerHorizontal="true" android:layout_marginTop="250dp" android:onClick="gestureClassifer" android:text="Gesture Classifier" />

<Button
android:id="@+id/btn_gestureTyping" android:layout_width="170dp" android:layout_height="wrap_content" android:layout_centerHorizontal="true" android:layout_marginTop="350dp" android:onClick="gestureTyping" android:text="Gesture Typing" />

<Button
android:id="@+id/btn_stats" android:layout_width="170dp" android:layout_height="wrap_content" android:layout_centerHorizontal="true" android:layout_marginTop="450dp" android:onClick="showStats" android:text="Stats" />
</RelativeLayout>

## DeviceListActivity.java

import androidx.appcompat.app.AppCompatActivity; import java.util.Set;
import android.bluetooth.BluetoothAdapter; import android.bluetooth.BluetoothDevice; import android.content.Intent;
import android.os.Bundle;
import android.view.View;
import android.widget.AdapterView; import android.widget.ArrayAdapter; import android.widget.ListView;
import android.widget.TextView;
import android.widget.Toast;
import android.widget.AdapterView.OnItemClickListener;

public class DeviceListActivity extends AppCompatActivity {

private static final String TAG = "DeviceListActivity";

//An EXTRA to take the device MAC to the next activity public static String EXTRA_DEVICE_ADDRESS;

// textview for connection status
TextView textConnectionStatus;
ListView pairedListView;

// Member fields
private BluetoothAdapter mBtAdapter;
private ArrayAdapter<String> mPairedDevicesArrayAdapter;

// For determining where activity to go
private static String key;

@Override
protected void onCreate(Bundle savedInstanceState) {
super.onCreate(savedInstanceState); setContentView(R.layout.activity_main);

textConnectionStatus = (TextView) findViewById(R.id.connecting); textConnectionStatus.setTextSize(40);

// Initialize array adapter for paired devices
mPairedDevicesArrayAdapter = new ArrayAdapter<String>(this, R.layout.device_name);

// Find and set up the ListView for paired devices
pairedListView = (ListView) findViewById(R.id.paired_devices); pairedListView.setAdapter(mPairedDevicesArrayAdapter);

// Find and set up the ListView for paired devices
ListView pairedListView = (ListView) findViewById(R.id.paired_devices); pairedListView.setAdapter(mPairedDevicesArrayAdapter); pairedListView.setOnItemClickListener(mDeviceClickListener);

}

@Override
public void onResume()
{
super.onResume();
//It is best to check BT status at onResume in case something has changed while app was paused etc

checkBTState();

// clears the array so items aren't duplicated when resuming from onPause mPairedDevicesArrayAdapter.clear();

//makes the textview blank
textConnectionStatus.setText(" ");

// Get the local Bluetooth adapter
mBtAdapter = BluetoothAdapter.getDefaultAdapter();

// Get a set of currently paired devices and append to pairedDevices list Set<BluetoothDevice> pairedDevices = mBtAdapter.getBondedDevices();

// Add previously paired devices to the array
if (pairedDevices.size() > 0) {
//make title viewable
findViewById(R.id.title_paired_devices).setVisibility(View.VISIBLE); for (BluetoothDevice device : pairedDevices) { mPairedDevicesArrayAdapter.add(device.getName() + "\n" + device.getAddress());
}
} else {
mPairedDevicesArrayAdapter.add("No devices paired"); }
}

//method to check if the device has Bluetooth and if it is on. //Prompts the user to turn it on if it is off
private void checkBTState()
{
// Check device has Bluetooth and that it is turned on mBtAdapter=BluetoothAdapter.getDefaultAdapter(); // CHECK THIS OUT THAT IT WORKS!!! if(mBtAdapter==null) {
Toast.makeText(getBaseContext(),
"Device does not support Bluetooth", Toast.LENGTH_SHORT).show(); finish();
} else {
if (!mBtAdapter.isEnabled()) {
//Prompt user to turn on Bluetooth
Intent enableBtIntent = new Intent(BluetoothAdapter.ACTION_REQUEST_ENABLE); startActivityForResult(enableBtIntent, 1);
}
}
}

private OnItemClickListener mDeviceClickListener = new OnItemClickListener() {
public void onItemClick(AdapterView<?> av, View v, int arg2, long arg3) {
//textConnectionStatus.setText("Connecting..."); Toast.makeText(getBaseContext(),
"Connecting....", Toast.LENGTH_SHORT).show();

// Get the device MAC address, which is the last 17 chars in the View String info = ((TextView) v).getText().toString();
String address = info.substring(info.length() - 17);

// Get the current intent
Intent intent = getIntent();

// Get the attached extras from the intent key = intent.getStringExtra(MainMenu.KEY);

// Variables for key comparison

String classify = "classify";
String type = "type";

// The key determines where will be the next activity if(classify.equals(key)){
// Make an intent to start next activity while taking an extra which is the MAC address.
Intent intent1 = new Intent(DeviceListActivity.this, MainActivity.class); intent1.putExtra(EXTRA_DEVICE_ADDRESS, address);
startActivity(intent1);
} else if (type.equals(key)){
// Make an intent to start next activity while taking an extra which is the MAC address.
Intent intent2 = new Intent(DeviceListActivity.this, GestureTyping.class); intent2.putExtra(EXTRA_DEVICE_ADDRESS, address);
startActivity(intent2);
} else {
Toast.makeText(getBaseContext(), key, Toast.LENGTH_SHORT).show(); }
}
};
}

## DeviceListActivity.xml

<?xml version="1.0" encoding="utf-8"?>
<TextView xmlns:android="http://schemas.android.com/apk/res/android"android:layout_width="match_parent"android:layout_height="wrap_content"
android:textSize="18sp"
android:padding="5dp">

</TextView>

MainActivity.java;

import androidx.annotation.NonNull;
import androidx.appcompat.app.AppCompatActivity; import android.annotation.SuppressLint;
import android.os.Bundle;
import java.io.BufferedReader;
import java.io.IOException;
import java.io.InputStream; import java.io.InputStreamReader; import java.io.OutputStream;
import java.text.DecimalFormat;
import java.util.UUID;
import android.bluetooth.BluetoothAdapter; import android.bluetooth.BluetoothDevice; import android.bluetooth.BluetoothSocket; import android.content.Intent;
import android.os.Handler;
import android.util.Log;
import android.widget.TextView;
import android.widget.Toast;

public class MainActivity extends AppCompatActivity {

private static final String TAG = "MainActivity";
private static final String FILE_NAME = "dataset.txt";

// Text Views
TextView letter, label1, label2, label3, confidence1, confidence2, confidence3; TextView flex1, flex2, flex3, flex4, flex5, gyroX, gyroY, gyroZ, accX, accY, accZ; TextView txtString, txtStringLength;

Handler bluetoothIn;
final int handlerState = 0; | //used to identify handler message

private BluetoothAdapter bluetoothAdapter = null;
private BluetoothSocket btSocket = null;

// Contains the string received from Bluetooth
private StringBuilder recDataString = new StringBuilder();

// Create Thread
private ConnectedThread mConnectedThread;

// SPP UUID service - this should work for most devices
private static final UUID BTMODULEUUID = UUID.fromString("00001101-0000-1000-8000-00805F9B34FB");

// String for MAC address
private static String address;
public int counter = 0;

@Override
public void onCreate(Bundle savedInstanceState) { super.onCreate(savedInstanceState);

setContentView(R.layout.activity_main2);

// Link the buttons and textViews to respective views txtString = findViewById(R.id.txtString); txtStringLength = findViewById(R.id.testView1); flex1 = findViewById(R.id.FlexSensor1);
flex2 = findViewById(R.id.FlexSensor2);
flex3 = findViewById(R.id.FlexSensor3);

flex4 = findViewById(R.id.FlexSensor4); flex5 = findViewById(R.id.FlexSensor5); gyroX = findViewById(R.id.GyroX);
gyroY = findViewById(R.id.GyroY);
gyroZ = findViewById(R.id.GyroZ);
accX = findViewById(R.id.AccelerometerX); accY = findViewById(R.id.AccelerometerY); accZ = findViewById(R.id.AcceleromterZ); letter = findViewById(R.id.text_letter); label1 = findViewById(R.id.text_label1);
label2 = findViewById(R.id.text_label2);
label3 = findViewById(R.id.text_label3); confidence1 = findViewById(R.id.text_confidence1); confidence2 = findViewById(R.id.text_confidence2); confidence3 = findViewById(R.id.text_confidence3);

bluetoothIn = new Handler() { @SuppressLint("HandlerLeak")
public void handleMessage(android.os.Message msg) { if (msg.what == handlerState) {
String readMessage = (String) msg.obj; recDataString.append(readMessage);
int endOfLineIndex = recDataString.indexOf("~");
if (endOfLineIndex > 0) {
String dataInPrint = recDataString.substring(0, endOfLineIndex); txtString.setText("Data Received = " + dataInPrint);
int dataLength = dataInPrint.length(); txtStringLength.setText("String Length = " + String.valueOf(dataLength));

//if it starts with # we know it is what we are looking for if (recDataString.charAt(0) == '#')
{
// Parse the packet String into array of characters
String packet = recDataString.substring(1, endOfLineIndex); String[] values = packet.split(",");

// Store the values in the array into variables
String f1 = values[0];
String f2 = values[1];
String f3 = values[2];
String f4 = values[3];
String f5 = values[4];
String gx = values[5];
String gy = values[6];
String gz = values[7];
String ax = values[8];
String ay = values[9];
String az = values[10];

// Set the textViews and show their values flex1.setText(" F1 = " + f1); flex2.setText(" F2 = " + f2); flex3.setText(" F3 = " + f3); flex4.setText(" F4 = " + f4); flex5.setText(" F5 = " + f5); gyroX.setText(" Gx = " + gx); gyroY.setText(" Gy = " + gy); gyroZ.setText(" Gz = " + gz); accX.setText(" Ax = " + ax); accY.setText(" Ay = " + ay); accZ.setText(" Az = " + az);

// Create a classifier object
Classifier classifier = new Classifier();

// Prepare testFeatures inputs in the object classifier.setFlex1(f1);
classifier.setFlex2(f2);
classifier.setFlex3(f3);
classifier.setFlex4(f4);
classifier.setFlex5(f5);
classifier.setGyroX(gx);
classifier.setGyroY(gy);
classifier.setGyroZ(gz);
classifier.setAccX(ax);
classifier.setAccY(ay);
classifier.setAccZ(az);

// Prepare the trained features and label values BufferedReader reader = null;
try {
String line;
// Get it from the text file and store it in a List reader = new BufferedReader(
new InputStreamReader(
getAssets().open(FILE_NAME), "UTF-8"));

// Do reading, usually loop until end of file reading while ((line = reader.readLine()) != null) { String[] split = line.split(",");
double[] feature = new double[split.length - 1];

// Store each line in an array
for (int i = 0; i < split.length - 1; i++) feature[i] = Double.parseDouble(split[i]);

// Add the trained features and labels in the object classifier.AddTrainedFeatures(feature); classifier.AddTrainedLabel(split[feature.length]); }
} catch (IOException e) {
Log.e(TAG, "Error: " + e);
} finally {
if (reader != null) {
try {
reader.close();
} catch (IOException e) {
Log.e(TAG, "Error: " + e); }
}
}

// Process the test inputs and trained inputs in the object classifier.Classify();

// Get the label and confidence output from the object
// Print the text to UI
letter.setText(classifier.GetLabel(0));
label1.setText("1. | " + classifier.GetLabel(0));
label2.setText("2. | " + classifier.GetLabel(1));
label3.setText("3. | " + classifier.GetLabel(2));
DecimalFormat df2 = new DecimalFormat("#.##"); confidence1.setText(df2.format(classifier.GetConfidence(0)) + "%");
confidence2.setText(df2.format(classifier.GetConfidence(1)) + "%");
confidence3.setText(df2.format(classifier.GetConfidence(2)) + "%");

Log.i(TAG, "tag_handler");

}
//clear all string data
recDataString.delete(0, recDataString.length()); }
}
}
};

bluetoothAdapter = BluetoothAdapter.getDefaultAdapter(); // get Bluetooth adapter checkBTState();
}

@Override
public void onResume() {
super.onResume();
Log.i(TAG, "tag_onResume");
//Get MAC address from DeviceListActivity via intent
Intent intent = getIntent();

//Get the MAC address from the DeviceListActivity via EXTRA
address = intent.getStringExtra(DeviceListActivity.EXTRA_DEVICE_ADDRESS);

//create device and set the MAC address
BluetoothDevice device = bluetoothAdapter.getRemoteDevice(address);

try {
btSocket = createBluetoothSocket(device);
} catch (IOException e) {
Toast.makeText(getBaseContext(), "Socket creation failed", Toast.LENGTH_LONG).show();
}
// Establish the Bluetooth socket connection.
try
{
btSocket.connect();
} catch (IOException e) {
try
{
btSocket.close();
} catch (IOException e2)
{
//insert code to deal with this
}
}
mConnectedThread = new ConnectedThread(btSocket); mConnectedThread.start();

//I send a character when resuming.beginning transmission to check device is connected
//If it is not an exception will be thrown in the write method and finish() will be called
mConnectedThread.write("x");
}

@Override
public void onPause()
{
Log.i(TAG, "tag_onPause"); super.onPause();
try
{
//Don't leave Bluetooth sockets open when leaving activity btSocket.close();

} catch (IOException e2) { //insert code to deal with this
}
}

private BluetoothSocket createBluetoothSocket(BluetoothDevice device) throws IOException {
//creates secure outgoing connection with BT device using UUID
return device.createRfcommSocketToServiceRecord(BTMODULEUUID);
}

//Checks that the Android device Bluetooth is available and prompts to be turned on if off
private void checkBTState() {

if(bluetoothAdapter==null) {
Toast.makeText(getBaseContext(),
"Device does not support bluetooth", Toast.LENGTH_LONG).show(); } else {
if (bluetoothAdapter.isEnabled()) {
} else {
Intent enableBtIntent = new Intent(BluetoothAdapter.ACTION_REQUEST_ENABLE); startActivityForResult(enableBtIntent, 1);
}
}
}

//create new class for connect thread
private class ConnectedThread extends Thread { private final InputStream mmInStream;
private final OutputStream mmOutStream;

//creation of the connect thread
public ConnectedThread(BluetoothSocket socket) { InputStream tmpIn = null;
OutputStream tmpOut = null;

try {
//Create I/O streams for connection tmpIn = socket.getInputStream(); tmpOut = socket.getOutputStream(); } catch (IOException e) { }

mmInStream = tmpIn;
mmOutStream = tmpOut;
}

public void run() {
byte[] buffer = new byte[256];
int bytes;

// Keep looping to listen for received messages while (true) {
try {
Log.i(TAG, "tag_firstThread");
//read bytes from input buffer
bytes = mmInStream.read(buffer);
String readMessage = new String(buffer, 0, bytes);
// Send the obtained bytes to the UI Activity via handler bluetoothIn.obtainMessage(handlerState, bytes, -1, readMessage).sendToTarget(); Log.i(TAG, "tag_secondThread");
} catch (IOException e) {
break;
}

}
}
//write method
public void write(String input) { //converts entered String into bytes
byte[] msgBuffer = input.getBytes();
try {
//write bytes over BT connection via outstream mmOutStream.write(msgBuffer);
} catch (IOException e) {
//if you cannot write, close the application Toast.makeText(getBaseContext(), "Connection Failure", Toast.LENGTH_LONG).show(); finish();

}
}
}
}

## MainActivity.xml

<RelativeLayout xmlns:android="http://schemas.android.com/apk/res/android"xmlns:tools="http://schemas.android.com/tools"android:layout_width="match_parent"android:layout_height="match_parent"android:paddingBottom="@dimen/activity_vertical_margin"android:paddingLeft="@dimen/activity_horizontal_margin"android:paddingRight="@dimen/activity_horizontal_margin"android:paddingTop="@dimen/activity_vertical_margin" >

<TextView
android:id="@+id/text_letter" android:layout_width="wrap_content" android:layout_height="wrap_content" android:layout_centerHorizontal="true" android:text="A"
android:textSize="200dp"
/>
<!--Labels-->
<TextView
android:id="@+id/text_label" android:layout_width="wrap_content" android:layout_height="wrap_content" android:layout_below="@+id/text_letter" android:layout_marginTop="10dp" android:layout_marginLeft="90dp" android:text="Label" />

<TextView
android:id="@+id/text_label1" android:layout_width="wrap_content" android:layout_height="wrap_content" android:layout_below="@+id/text_label" android:layout_marginTop="10dp" android:layout_marginLeft="90dp" android:text="1. ?" />

<TextView
android:id="@+id/text_label2" android:layout_width="wrap_content" android:layout_height="wrap_content" android:layout_below="@+id/text_label1" android:layout_marginTop="10dp"

android:layout_marginLeft="90dp" android:text="2. ?" />

<TextView
android:id="@+id/text_label3" android:layout_width="wrap_content" android:layout_height="wrap_content" androi

d:layout_below="@+id/text_label2" android:layout_marginTop="10dp" android:layout_marginLeft="90dp" android:text="3. ?" />

<!--Confidence--

>
<TextView
android:id="@+id/text_confidence" android:layout_widt

h="wrap_content"
android:layout_height="wrap_content" android:layout_below="@+id/text_letter" android:layout_marginTop="10dp" android:layout_alignParentRight="true" android:layout_marginRight="90dp" android:text="Confidence" />

<TextView
android:id="@+id/text_confidence1" android:layout_width="wrap_content" android:layout_height="wrap_content" android:layout_below="@+id/text_confidence" android:layout_marginTop="10dp"
androi

d:layout_alignParentRight="true" android:layout_marginRight="105dp" android:text="33.33%" />

<TextView
android:id="@+id/text_confidence2" android:layout_width="wrap_content" android:layout_height="wrap_content" android:layout_below="@+id/text_label1" android:layout_marginTop="10dp" android:layout_alignParentRight="true" android:layout_marginRight="105dp" android:text="33.33%" />

<TextView
android:id="@+id/text_confidence3" android:layout_width="wrap_content" android:layout_height="wrap_content" android:layout_below="@+id/text_label2" android:layout_marginTop="10dp" android:layout_alignParentRight="true" android:layout_marginRight="105dp" android:text="33.33%" />
<!--Gloves' Sensor Values--

>
<TextView
android:id="@+id/GloveSensorValues" android:layout_width="wrap_content" android:layout_height="wrap_content" android:layout_below="@id/text_label3" android:layout_marginTop="20dp" android:layout_centerHorizontal="true" android:text="Gloves' Sensor Values" /> <!--Flex Sensor--

>
<TextView
android:id="@+id/FlexSensor"

android:layout_width="wrap_content" android:layout_height="wrap_content" android:layout_below="@id/GloveSensorValues" android:layout_marginTop="20dp" android:layout_marginLeft="40dp" android:text="Flex Sensors" />

<TextVie

w
android:id="@+id/FlexSensor1" android:layout_width="wrap_content" android:layout_height="wrap_content" android:layout_below="@id/FlexSensor" android:layout_marginTop="10dp" android:layout_marginLeft="40dp" android:text="F1 = ??????.??" />

<TextView
android:id="@+id/FlexSensor2" android:layout_width="wrap_content" android:layout_height="wrap_content" android:layout_below="@+id/FlexSensor1" android:layout_marginTop="10dp" android:layout_marginLeft="40dp" android:text="F2 = ??????.??" />

<TextView
android:id="@+id/FlexSensor3" android:layout_width="wrap_content" android:layout_height="wrap_content" android:layout_below="@+id/FlexSensor2" android:layout_marginTop="10dp" android:layout_marginLeft="40dp" android:text="F3 = ??????.??" />

<TextView
android:id="@+id/FlexSensor4" android:layout_width="wrap_content" android:layout_height="wrap_content" android:layout_below="@+id/FlexSensor3" android:layout_marginTop="10dp" android:layout_marginLeft="40dp" android:text="F4 = ??????.??" />

<TextView
android:id="@+id/FlexSensor5" android:layout_width="wrap_content" android:layout_height="wrap_content" android:layout_below="@+id/FlexSensor4" android:layout_marginTop="10dp" android:layout_marginLeft="40dp" android:text="F5 = ??????.??" /> <!--GyroScope--

>
<TextView
android:id="@+id/Gyroscope" android:layout_width="wrap_content" android:layout_height="wrap_content" android:layout_below="@id/GloveSensorValues" android:layout_marginTop="20dp" android:layout_centerHorizontal="true" android:text="Gyroscope" />

<TextView
android:id="@+id/GyroX"
android:layout_width="wrap_content" android:layout_height="wrap_content"

android:layout_below="@+id/Gyroscope" android:layout_centerHorizontal="true" android:layout_marginTop="10dp" android:text="Gx = ?????" />

<TextView
android:id="@+id/GyroY"
android:layout_width="wrap_content" android:layout_height="wrap_content" android:layout_below="@+id/GyroX" android:layout_centerHorizontal="true" android:layout_marginTop="10dp" android:text="Gy = ?????" />

<TextView
android:id="@+id/GyroZ"
android:layout_width="wrap_content" android:layout_height="wrap_content" android:layout_below="@+id/GyroY" android

:layout_marginTop="10dp"
android:layout_centerHorizontal="true" android:text="Gz = ?????" />

<!--Accelerometer--

>

<TextView
android:id="@+id/Accelerometer" android:layout_width="wrap_content" android:layout_height="wrap_content" android:layout_below="@id/GloveSensorValues" android:layout_toRightOf="@id/Gyroscope" android:layout_marginTop="20dp" android:layout_marginLeft="40dp" android:layout_centerHorizontal="true" android:text="Accelerometer" />

<TextView
android:id="@+id/AccelerometerX" android:layout_width="wrap_content" android:layout_height="wrap_content" android:layout_below="@+id/Accelerometer" android:layout_toRightOf="@id/Gyroscope" android:layout_marginTop="10dp" android:layout_marginLeft="40dp" android:text="Ax = ?????" />
<TextView
android:id="@id/AccelerometerY" android:layout_width="wrap_content" android:layout_height="wrap_content" android:layout_below="@+id/AccelerometerX" android:layout_toRightOf="@id/Gyroscope" android:layout_marginTop="10dp" android:layout_marginLeft="40dp" android:text="Ay = ?????" />

<TextView
android:id="@+id/AcceleromterZ" android:layout_width="wrap_content" android:layout_height="wrap_content" android:layout_below="@+id/AccelerometerY" android:layout_toRightOf="@id/Gyroscope" android:layout_marginTop="10dp" android:layout_marginLeft="40dp" android:text="Az = ?????" />

<TextView
android:id="@+id/testView1" android:layout_width="wrap_content" android:layout_height="wrap_content" android:layout_above="@+id/txtString" android:text=""
android:textSize="15sp" />

<TextView
android:id="@+id/txtString" android:layout_width="wrap_content" android:layout_height="50dp" android:layout_alignLeft="@+id/testView1" android:layout_alignParentBottom="true" android:text=""
android:textSize="15sp" />

</RelativeLayout>

## GestureTyping.java

import androidx.annotation.NonNull;
import androidx.appcompat.app.AppCompatActivity;

import android.annotation.SuppressLint;
import android.app.Dialog;
import android.bluetooth.BluetoothAdapter; import android.bluetooth.BluetoothDevice; import android.bluetooth.BluetoothSocket; import android.content.Intent;
import android.graphics.Color;
import android.os.Bundle;
import android.os.Handler;
import android.text.SpannableString;
import android.text.Spanned;
import android.text.style.ForegroundColorSpan; import android.util.Log;
import android.widget.TextView;
import android.widget.Toast;
import java.io.BufferedReader; import java.io.FileNotFoundException; import java.io.FileOutputStream; import java.io.IOException;
import java.io.InputStream;
import java.io.InputStreamReader; import java.io.OutputStream; import java.text.DecimalFormat; import java.text.SimpleDateFormat; import java.util.ArrayList; import java.util.Date;
import java.util.List;
import java.util.Locale;
import java.util.Random;
import java.util.UUID;

public class GestureTyping extends AppCompatActivity implements CompleteDialog.ExampleDialogListener {

// Log Tag
private static final String TAG = "GestureTyping"; private static final String FILE_NAME = "gameData.txt"; private static final String DATASET = "dataset.txt";

// Text Views
TextView letter, label1, label2, label3; TextView confidence1, confidence2, confidence3; TextView sentence, timer;

// Handler
Handler bluetoothIn;

// Use to identify handler message
final int handlerState = 0;

// Bluetooth
private BluetoothAdapter btAdapter = null;
private BluetoothSocket btSocket = null;

// Contains the string received from Bluetooth
private StringBuilder recDataString = new StringBuilder();

// Threads
private GestureTyping.ConnectedThread mConnectedThread;
private Timer timerThread;

// SPP UUID service - this should work for most devices
private static final UUID BTMODULEUUID = UUID.fromString("00001101-0000-1000-8000-00805F9B34FB");

// String for MAC address
private static String address;

// Serves as pointer of the current character the user is typing private int counter;

// Game timer
private int seconds;

// Checks if the game is complete private boolean isComplete;

// Sentence to type on
private String givenSentence;

// TypeSpeed and Accuracy
private double speed, accuracy;

// User's total character input
private int totalEntries;

@Override
protected void onSaveInstanceState(@NonNull Bundle outState) { super.onSaveInstanceState(outState); outState.putInt("counter", counter); outState.putInt("seconds", seconds);
}

@Override
public void onCreate(Bundle savedInstanceState) { super.onCreate(savedInstanceState); setContentView(R.layout.activity_gesture_typing);

if (savedInstanceState != null) {
counter = savedInstanceState.getInt("counter"); seconds = savedInstanceState.getInt("seconds"); }

// Link the buttons and textViews to respective views timer = findViewById(R.id.timer); sentence = findViewById(R.id.sentence); letter = findViewById(R.id.text_letter); label1 = findViewById(R.id.text_label1);
label2 = findViewById(R.id.text_label2);
label3 = findViewById(R.id.text_label3); confidence1 = findViewById(R.id.text_confidence1); confidence2 = findViewById(R.id.text_confidence2); confidence3 = findViewById(R.id.text_confidence3);

initializeActivity();

bluetoothIn = new Handler() { @SuppressLint("HandlerLeak")
public void handleMessage(android.os.Message msg) { if (msg.what == handlerState) {
String readMessage = (String) msg.obj; recDataString.append(readMessage);
int endOfLineIndex = recDataString.indexOf("~");
if (endOfLineIndex > 0) {
//if it starts with # we know it is what we are looking for if (recDataString.charAt(0) == '#')
{
// Parse the packet String into array of characters
String packet = recDataString.substring(1, endOfLineIndex); String[] values = packet.split(",");

// Store the values in the array into variables
String f1 = values[0];
String f2 = values[1];
String f3 = values[2];
String f4 = values[3];
String f5 = values[4];
String gx = values[5];
String gy = values[6];
String gz = values[7];
String ax = values[8];
String ay = values[9];
String az = values[10];

// Create a classifier object
Classifier classifier = new Classifier();

// Prepare testFeatures inputs in the object classifier.setFlex1(f1);
classifier.setFlex2(f2);
classifier.setFlex3(f3);
classifier.setFlex4(f4);
classifier.setFlex5(f5);
classifier.setGyroX(gx);
classifier.setGyroY(gy);
classifier.setGyroZ(gz);
classifier.setAccX(ax);
classifier.setAccY(ay);
classifier.setAccZ(az);

// Prepare the trained features and label values BufferedReader reader = null;
try {
String line;
// Get it from the text file and store it in a List reader = new BufferedReader(
new InputStreamReader(
getAssets().open(DATASET), "UTF-8"));

// Do reading, usually loop until end of file reading while ((line = reader.readLine()) != null) { String[] split = line.split(",");
double[] feature = new double[split.length - 1];

// Store each line in an array
for (int i = 0; i < split.length - 1; i++) feature[i] = Double.parseDouble(split[i]);

// Add the trained features and labels in the object classifier.AddTrainedFeatures(feature); classifier.AddTrainedLabel(split[feature.length]); }
} catch (IOException e) {
Log.e(TAG, "Error: " + e);
} finally {
if (reader != null) {
try {
reader.close();
} catch (IOException e) {
Log.e(TAG, "Error: " + e); }
}
}

// Process the test inputs and trained inputs in the object classifier.Classify();

// Get the label and confidence output from the object
// Print the text to UI
letter.setText(classifier.GetLabel(0));
label1.setText("1. | " + classifier.GetLabel(0));
label2.setText("2. | " + classifier.GetLabel(1));
label3.setText("3. | " + classifier.GetLabel(2));
DecimalFormat df2 = new DecimalFormat("#.##"); confidence1.setText(df2.format(classifier.GetConfidence(0)) + "%");
confidence2.setText(df2.format(classifier.GetConfidence(1)) + "%");
confidence3.setText(df2.format(classifier.GetConfidence(2)) + "%");

//======================FOR TYPING GAME=====================// Log.i(TAG, "tag_typingGame");
String text = givenSentence;
String letter = classifier.GetLabel(0);
Log.i(TAG, "letter" + letter);
String space = "Space";
if(letter.length() > 1){
Log.i(TAG, "SPACE");
letter = " ";
}

//Convert Text to List of Characters List<Character> charList = new ArrayList<>(); for (char ch : text.toCharArray()) { charList.add(ch);
}

// This is used for coloring characters
SpannableString ss = new SpannableString(text); ForegroundColorSpan fcsRed = new ForegroundColorSpan(Color.RED); ForegroundColorSpan fcsGreen = new ForegroundColorSpan(Color.GREEN);

// The users input
char input = letter.charAt(0);

// Compare the users input to the specific character char currentCharacter =
Character.toUpperCase(charList.get(counter)); if(input == currentCharacter){
// Change the color to green ss.setSpan(fcsGreen, 0, counter + 1, Spanned.SPAN_EXCLUSIVE_EXCLUSIVE); // Increment counter
counter++;
//Check if it is the last letter if(counter == charList.size()){ isComplete = true;
}
} else {
if(counter == 0){
// Change the color to red ss.setSpan(fcsRed, counter, counter + 1, Spanned.SPAN_EXCLUSIVE_EXCLUSIVE); } else{
// Change the color of the previous letters to green and current letter to red
ss.setSpan(fcsGreen, 0, counter, Spanned.SPAN_EXCLUSIVE_EXCLUSIVE); ss.setSpan(fcsRed, counter, counter + 1, Spanned.SPAN_EXCLUSIVE_EXCLUSIVE); }
}

totalEntries++;
sentence.setText(ss);
Log.i(TAG, "tag_handler");

}
//clear all string data
recDataString.delete(0, recDataString.length()); }
}
}
};
btAdapter = BluetoothAdapter.getDefaultAdapter(); | // get Bluetooth adapter
checkBTState();
}

public void initializeActivity(){
Log.i(TAG, "tag_initActivity"); // initialize variables
counter = 0;
seconds = 0;
isComplete = false;
try {
givenSentence = generateSentence(); } catch (IOException e) {
e.printStackTrace();
}
totalEntries = 0;

// create new timer thread timerThread = new Timer();
new Thread(timerThread).start();

// prepare textviews
timer.setText("0");
sentence.setText(givenSentence); letter.setText("-");
label1.setText("-");
label2.setText("-");
label3.setText("-");
confidence1.setText("-");
confidence2.setText("-");
confidence3.setText("-");
}

private String generateSentence() throws IOException { String generatedSentence = "" ;

// Generate random number from 0 to 5
Random random = new Random();
int fileNum = random.nextInt(5);
String fileName = Integer.toString(fileNum) + ".txt";

BufferedReader reader = null;
try {
String line;
reader = new BufferedReader(new InputStreamReader( getAssets().open(fileName), "UTF-8")); while ((line = reader.readLine()) != null) { generatedSentence = line;
}
} catch (IOException e) {
Log.e(TAG, "Error: " + e); } finally {
if (reader != null) {
try {
reader.close();
} catch (IOException e) {
Log.e(TAG, "Error: " + e); }
}
}
return generatedSentence;
}

public void save(double speed, double accuracy, String date) { FileOutputStream fos = null;
try {
// to delete, use MODE_PRIVATE, then change to MODE_APPEND fos = openFileOutput(FILE_NAME, MODE_APPEND);
} catch (FileNotFoundException e) {
e.printStackTrace();
}
String content =
String.format("%.2f",speed) + "," + String.format("%.2f",accuracy) + "," + date + "\n";
byte[] bytesArray = content.getBytes();
try {
fos.write(bytesArray);
} catch (IOException e) {
e.printStackTrace();
}
}

public void openDialog(){
CompleteDialog completeDialog = new CompleteDialog(); completeDialog.setSpeed(speed); completeDialog.setAccuracy(accuracy);

completeDialog.show(getSupportFragmentManager(), "complete dialog"); Log.i(TAG, "tag_openDialog");
}

@Override
public void onResume() {
super.onResume();
Log.i(TAG, "tag_onResume");
//Get MAC address from DeviceListActivity via intent
Intent intent = getIntent();

//Get the MAC address from the DeviceListActivity via EXTRA
address = intent.getStringExtra(DeviceListActivity.EXTRA_DEVICE_ADDRESS);

//create device and set the MAC address
BluetoothDevice device = btAdapter.getRemoteDevice(address);

try {
btSocket = createBluetoothSocket(device);
} catch (IOException e) {
Toast.makeText(getBaseContext(), "Socket creation failed", Toast.LENGTH_LONG).show();
}
// Establish the Bluetooth socket connection.
try
{
btSocket.connect();
} catch (IOException e) {
try
{
btSocket.close();
} catch (IOException e2)
{
//insert code to deal with this
}
}

mConnectedThread = new GestureTyping.ConnectedThread(btSocket); mConnectedThread.start();

//I send a character when resuming.beginning transmission to check device is connected
//If it is not an exception will be thrown in the write method and finish() will be called
mConnectedThread.write("x");
}

@Override
public void onPause() {
Log.i(TAG, "tag_onPause"); super.onPause();
try
{
//Don't leave Bluetooth sockets open when leaving activity btSocket.close();
} catch (IOException e2) {
//insert code to deal with this
}
}

private BluetoothSocket createBluetoothSocket(BluetoothDevice device) throws IOException {
//creates secure outgoing connection with BT device using UUID
return device.createRfcommSocketToServiceRecord(BTMODULEUUID);
}

//Checks that the Android device Bluetooth is available and prompts to be turned on if off
private void checkBTState() {
if(btAdapter==null) {
Toast.makeText(getBaseContext(), "Device does not support bluetooth", Toast.LENGTH_LONG).show();
} else {
if (btAdapter.isEnabled()) {
} else {
Intent enableBtIntent = new Intent(BluetoothAdapter.ACTION_REQUEST_ENABLE); startActivityForResult(enableBtIntent, 1);
}
}
}

//create new class for connect thread
private class ConnectedThread extends Thread { private final InputStream mmInStream;
private final OutputStream mmOutStream;

//creation of the connect thread
public ConnectedThread(BluetoothSocket socket) { InputStream tmpIn = null;
OutputStream tmpOut = null;

try {
//Create I/O streams for connection tmpIn = socket.getInputStream(); tmpOut = socket.getOutputStream(); } catch (IOException e) { }

mmInStream = tmpIn;
mmOutStream = tmpOut;
}

public void run() {
byte[] buffer = new byte[256];
int bytes;

// Keep looping to listen for received messages while (true) {
try {
Log.i(TAG, "tag_firstThread");
//read bytes from input buffer
bytes = mmInStream.read(buffer);
String readMessage = new String(buffer, 0, bytes);
// Send the obtained bytes to the UI Activity via handler bluetoothIn.obtainMessage(handlerState, bytes, -1, readMessage).sendToTarget(); Log.i(TAG, "tag_secondThread");
} catch (IOException e) {
break;
}
}
}
//write method
public void write(String input) { //converts entered String into bytes
byte[] msgBuffer = input.getBytes();
try {
//write bytes over BT connection via outstream mmOutStream.write(msgBuffer);
} catch (IOException e) {
//if you cannot write, close the application

Toast.makeText(getBaseContext(), "Connection Failure", Toast.LENGTH_LONG).show(); finish();

}
}
}

private class Timer implements Runnable{ @Override
public void run() {
while(!isComplete){
try {
Thread.sleep(1000); //1000ms = 1 sec runOnUiThread(new Runnable() { @Override
public void run() {
seconds++;
timer.setText(String.valueOf(seconds)); }
});
} catch (InterruptedException e) { e.printStackTrace();
}
}

// compute for speed and accuracy
double wordChar = 5.00;
double minute = 60.00;
double wordsNum = (double) counter/wordChar; double time = (double) seconds/minute; speed = wordsNum/time;

// compute for accuracy
double acc = (double) counter/totalEntries; accuracy = acc*100;

Log.i(TAG, "speed = " + speed);
Log.i(TAG, "accuracy = " + accuracy); Log.i(TAG, "counter = " + counter); Log.i(TAG, "totalEntries = " + totalEntries);

// save speed and accuracy
String currentDate;
currentDate = new SimpleDateFormat("MM/ dd/ yy", Locale.getDefault()).format(new Date());
Log.i(TAG, currentDate);
save(speed,accuracy,currentDate);
openDialog();
}
}
}

## GestureTyping.xml

<RelativeLayout xmlns:android="http://schemas.android.com/apk/res/android"xmlns:tools="http://schemas.android.com/tools"android:layout_width="match_parent"android:layout_height="match_parent"android:paddingBottom="@dimen/activity_vertical_margin"android:paddingLeft="@dimen/activity_horizontal_margin"android:paddingRight="@dimen/activity_horizontal_margin"android:paddingTop="@dimen/activity_vertical_margin" >

<TextView
android:id="@+id/timer"
android:layout_width="wrap_content" android:layout_height="wrap_content" android:layout_centerHorizontal="true" android:text="0"
android:textSize="50sp"
android:layout_marginTop="50dp"
/>

<TextView
android:id="@+id/sentence" android:layout_width="300dp" android:layout_height="wrap_content" android:layout_centerHorizontal="true" android:layout_marginTop="150dp"
android:textSize="25sp"
android:text="THE QUICK BROWN FOX JUMP OVER THE LAZY DOG"/>

<TextView
android:id="@+id/text_letter" android:layout_width="wrap_content" android:layout_height="wrap_content" android:layout_centerHorizontal="true" android:text="A"
android:textSize="150dp"
android:layout_marginTop="300dp"
/>
<!--Labels-->
<TextView
android:id="@+id/text_label" android:layout_width="wrap_content" android:layout_height="wrap_content" android:layout_below="@+id/text_letter" android:layout_marginTop="10dp" android:layout_marginLeft="90dp" android:text="Label" />

<TextView
android:id="@+id/text_label1" android:layout_width="wrap_content" android:layout_height="wrap_content" android:layout_below="@+id/text_label" android:layout_marginTop="10dp" android:layout_marginLeft="90dp" android:text="1. ?" />

<TextView
android:id="@+id/text_label2" android:layout_width="wrap_content" android:layout_height="wrap_content" android:layout_below="@+id/text_label1" android:layout_marginTop="10dp"

android:layout_marginLeft="90dp" android:text="2. ?" />

<TextView
android:id="@+id/text_label3" android:layout_width="wrap_content" android:layout_height="wrap_content" android:layout_below="@+id/text_label2" android:layout_marginTop="10dp" android:layout_marginLeft="90dp" android:text="3. ?" />

<!--Confidence-->
<TextView
android:id="@+id/text_confidence" android:layout_width="wrap_content" android:layout_height="wrap_content" android:layout_below="@+id/text_letter" android:layout_marginTop="10dp" android:layout_alignParentRight="true" android:layout_marginRight="90dp" android:text="Confidence" />

<TextView
android:id="@+id/text_confidence1" android:layout_width="wrap_content" android:layout_height="wrap_content" android:layout_below="@+id/text_confidence" android:layout_marginTop="10dp" android:layout_alignParentRight="true" android:layout_marginRight="105dp" android:text="33.33%" />

<TextView
android:id="@+id/text_confidence2" android:layout_width="wrap_content" android:layout_height="wrap_content" android:layout_below="@+id/text_label1" android:layout_marginTop="10dp" android:layout_alignParentRight="true" android:layout_marginRight="105dp" android:text="33.33%" />

<TextView
android:id="@+id/text_confidence3" android:layout_width="wrap_content" android:layout_height="wrap_content" android:layout_below="@+id/text_label2" android:layout_marginTop="10dp" android:layout_alignParentRight="true" android:layout_marginRight="105dp" android:text="33.33%" />

</RelativeLayout>

## CompleteDialog.java

import android.app.AlertDialog; import android.app.Dialog; import android.content.Context; import android.content.Intent; import android.os.Bundle;
import android.view.LayoutInflater; import android.view.View;
import android.widget.Button; import android.widget.TextView;
import androidx.annotation.NonNull;
import androidx.annotation.Nullable;
import androidx.appcompat.app.AppCompatDialogFragment; import java.text.DecimalFormat;

public class CompleteDialog extends AppCompatDialogFragment {

private TextView txtSpeed, txtAccuracy;
private Button btnMenu, btnNext;
private ExampleDialogListener listener;
private double speed, accuracy;

@NonNull
@Override
public Dialog onCreateDialog(@Nullable Bundle savedInstanceState) { AlertDialog.Builder builder = new AlertDialog.Builder(getActivity()); LayoutInflater inflater = getActivity().getLayoutInflater();
View view = inflater.inflate(R.layout.layout_dialog, null);

// Build the dialog with the builder
builder.setView(view);

// link textViews and buttons
txtSpeed = view.findViewById(R.id.txtSpeed); txtAccuracy = view.findViewById(R.id.txtAccuracy); btnMenu = view.findViewById(R.id.btnMenu); btnNext = view.findViewById(R.id.btnNext);

// setup the dialog box
DecimalFormat df2 = new DecimalFormat("#.##"); txtSpeed.setText("Speed : " + df2.format(speed) + "WPM"); txtAccuracy.setText("Accuracy : " + df2.format(accuracy) + "%");

btnNext.setOnClickListener(new View.OnClickListener() { @Override
public void onClick(View v) {
// refresh the GestureTyping activity listener.initializeActivity();
// close the dialog
getDialog().dismiss();
}
});
btnMenu.setOnClickListener(new View.OnClickListener() { @Override
public void onClick(View v) {
// return to menu
Intent intent = new Intent(v.getContext(), MainMenu.class); startActivity(intent);
}
});

return builder.create();
}

public void setSpeed(double speed){ this.speed = speed;
}

public void setAccuracy(double accuracy){ this.accuracy = accuracy;
}

@Override
public void onAttach(Context context) { super.onAttach(context);
try {
listener = (ExampleDialogListener) context;
} catch (ClassCastException e) {
throw new ClassCastException(context.toString() + "must implement ExampleDialogListener"); }
}

public interface ExampleDialogListener { void initializeActivity();
}
}

## CompleteDialog.xml

<?xml version="1.0" encoding="utf-8"?>
<RelativeLayout xmlns:android="http://schemas.android.com/apk/res/android"android:layout_width="match_parent"android:layout_height="match_parent"
android:padding="20dp">

<TextView
android:id="@+id/txtSpeed" android:layout_width="match_parent" android:layout_height="wrap_content" android:gravity="center"
android:text="Speed : 30 WPM" android:layout_centerHorizontal="true" android:textSize="30sp"
/>
<TextView
android:id="@+id/txtAccuracy" android:layout_width="match_parent" android:layout_height="wrap_content" android:gravity="center"
android:text="Accuracy : 65.35%" android:layout_below="@+id/txtSpeed" android:textSize="30sp"
/>
<Button
android:id="@+id/btnMenu"
android:layout_width="wrap_content" android:layout_height="wrap_content" android:text="MENU"
android:layout_below="@+id/btnNext" android:layout_marginTop="10dp" android:layout_centerHorizontal="true" />
<Button
android:id="@+id/btnNext"

android:layout_width="wrap_content" android:layout_height="wrap_content" android:text="NEXT"
android:layout_below="@+id/txtAccuracy" android:layout_marginTop="10dp" android:layout_centerHorizontal="true" />
</RelativeLayout>

## StatsActivity.java

import androidx.appcompat.app.AppCompatActivity;

import android.graphics.Color;
import android.os.Bundle;
import android.widget.TextView;

import java.io.BufferedReader; import java.io.FileInputStream; import java.io.FileNotFoundException; import java.io.IOException;
import java.io.InputStreamReader; import java.util.ArrayList;
import java.util.List;

import lecho.lib.hellocharts.model.Axis;
import lecho.lib.hellocharts.model.AxisValue; import lecho.lib.hellocharts.model.Line;
import lecho.lib.hellocharts.model.LineChartData; import lecho.lib.hellocharts.model.PointValue; import lecho.lib.hellocharts.model.Viewport;
import lecho.lib.hellocharts.view.LineChartView;

public class StatsActivity extends AppCompatActivity{

private static final String TAG = "StatsActivity";
TextView gamesPlayed, speedRecord, averageSpeed, averageAccuracy; private static final String FILE_NAME = "gameData.txt";

@Override
protected void onCreate(Bundle savedInstanceState) { super.onCreate(savedInstanceState); setContentView(R.layout.activity_stats);

gamesPlayed = findViewById(R.id.gamesPlayed); speedRecord = findViewById(R.id.speedRecord); averageSpeed = findViewById(R.id.averageSpeed); averageAccuracy = findViewById(R.id.averageAccuracy); try {
load();
} catch (IOException e) {
e.printStackTrace();
}
}

public void load() throws IOException { // Open the file
FileInputStream fileInputStream = null;
try {
fileInputStream = openFileInput(FILE_NAME); } catch (FileNotFoundException e) { e.printStackTrace();
}

// Get the data from the file
InputStreamReader inputStreamReader = new InputStreamReader(fileInputStream); BufferedReader bufferedReader = new BufferedReader(inputStreamReader); List<String[]> gameDataList = new ArrayList<>();
String string;
while ((string = bufferedReader.readLine()) != null) {
String[] split = string.split(",");
String[] gameData = new String[split.length];
for (int index = 0; index < split.length; index++) { gameData[index] = split[index];
}
gameDataList.add(gameData);
}

// Use the data to show statistics
Statistics statistics = new Statistics(); statistics.setSpeedAccuracyList(gameDataList);
gamesPlayed.setText("Games Played: " + statistics.getGamesPlayedCount()); speedRecord.setText("Speed Record: " + statistics.getSpeedRecord() + "WPM"); averageSpeed.setText("Average Speed: " + statistics.getAverageSpeed() + "WPM"); averageAccuracy.setText("Average Accuracy: " + statistics.getAverageAccuracy() + "%");

// Prepare data for x and y axis
List<String> xData = new ArrayList<>();
List<Float> yData = new ArrayList<>(); for(int i = 0; i < gameDataList.size(); i++){ String[] gameData = gameDataList.get(i); // store the date
xData.add(gameData[2]);
// store the speed
yData.add(Float.parseFloat(gameData[0]));
}

// Declare a list which will hold the values in x and y axis
List yAxisValues = new ArrayList();
List xAxisValues = new ArrayList();

// Declare and initialize the line that will show in the graph with set color Line line = new Line(yAxisValues).setColor(Color.parseColor("#9C27B0"));

// Initialize the X and Y axis values lists
for(int i = 0; i < xData.size(); i++){
xAxisValues.add(i, new AxisValue(i).setLabel(xData.get(i)));
}
for (int i = 0; i < yData.size(); i++){
yAxisValues.add(new PointValue(i, yData.get(i)));
}

// Declare a list that will hold the line of the graph chart List lines = new ArrayList();
lines.add(line);

// Add the graph line to the overall chart data LineChartData data = new LineChartData(); data.setLines(lines);

// View the android line chart
LineChartView lineChartView = findViewById(R.id.graph); lineChartView.setLineChartData(data);

// Show x and y axis
Axis axis = new Axis();
axis.setValues(xAxisValues);

data.setAxisXBottom(axis);

// Show y axis values
Axis yAxis = new Axis();
data.setAxisYLeft(yAxis);

// change x axis values text size axis.setTextSize(8);

// change text color of axis data axis.setTextColor(Color.parseColor("#03A9F4")); yAxis.setTextColor(Color.parseColor("#03A9F4"));

// adjust y axis maximum value
Viewport viewport = new Viewport(lineChartView.getMaximumViewport()); Float top = (float) statistics.getSpeedRecord() + 1;
viewport.top = top;
lineChartView.setMaximumViewport(viewport); lineChartView.setCurrentViewport(viewport);

// make the X axis labels tilt axis.setHasTiltedLabels(true);

}
}

## StatsActivity.xml

<?xml version="1.0" encoding="utf-8"?>
<RelativeLayout xmlns:android="http://schemas.android.com/apk/res/android"xmlns:app="http://schemas.android.com/apk/res-auto"xmlns:tools="http://schemas.android.com/tools"android:layout_width="match_parent"android:layout_height="match_parent"android:padding="20dp"
tools:context=".StatsActivity">

<lecho.lib.hellocharts.view.LineChartView android:id="@+id/graph"
android:layout_width="match_parent" android:layout_height="500dip" android:layout_below="@+id/gameHistory" android:padding="10dp"
/>
<TextView
android:id="@+id/gameHistory" android:layout_width="wrap_content" android:layout_height="wrap_content" android:text="Game History" android:textSize="25sp"
/>
<TextView
android:id="@+id/statistics" android:layout_width="wrap_content" android:layout_height="wrap_content" android:text="Statistics"
android:layout_below="@+id/graph" android:textSize="25sp"/>
<TextView
android:id="@+id/gamesPlayed" android:layout_width="wrap_content" android:layout_height="wrap_content" android:text="Games Played : ?" android:layout_below="@+id/statistics"

android:textSiz

e="20sp"/>
<TextView
android:id="@+id/speedRecord" android:layout_width="wrap_content" android:layout_height="wrap_content" android:text="Speed Record : ?" android:layout_below="@+id/gamesPlayed" android:textSize="20sp"/>
<TextView
android:id="@+id/averageSpeed" android:layout_width="wrap_content" android:layout_height="wrap_content" android:text="Average Speed : ?" android:layout_below="@+id/speedRecord" android:textSize="20sp"/>
<TextView
android:id="@+id/averageAccuracy" android:layout_width="wrap_content" android:layout_height="wrap_content" android:text="Average Accuracy : ?" android:layout_below="@+id/averageSpeed" android:textSize="20sp"/>

</RelativeLayout

>

## Classifier.java

package com.example.wingoodharry; import java.util.ArrayList; import java.util.HashMap;
import java.util.List;
import java.util.Map;

public class Classifier {
private static final String

TAG = "Classifier"

;
private double flex1

;
private double flex2

;
private double flex3

;
private double flex4

;
private double flex5

;
private double gyroX

;
private double gyroY

;
private double gyroZ

;
private double accX

;
private double accY

;
private double accZ

;
private double[] testFeatures

;
private List<double[]> trainedFeatures

;
private List<String> trainedLabel

;
private double[][] distanceList

;
private int

k

;
private List<String> targetLabel

s

;
private String[] topThreeLabel

;
private int[] topThreeLabelCount

;
private double[] topThreeConfidence

;

public Classifier() {
this

.k =

7

;
this

.trainedFeatures = new ArrayList<>(); this

.trainedLabel = new ArrayList<>(); this

.targetLabels = new ArrayList<>();

this.topThreeLabel = new String[3]; this.topThreeLabelCount = new int[3]; this.topThreeConfidence = new double[3]; }

public void setFlex1(String flex1) { this.flex1 = Double.parseDouble(flex1); }

public void setFlex2(String flex2) { this.flex2 = Double.parseDouble(flex2); }

public void setFlex3(String flex3) { this.flex3 = Double.parseDouble(flex3); }

public void setFlex4(String flex4) { this.flex4 = Double.parseDouble(flex4); }

public void setFlex5(String flex5) { this.flex5 = Double.parseDouble(flex5); }

public void setGyroX(String gyroX) { this.gyroX = Double.parseDouble(gyroX); }

public void setGyroY(String gyroY) { this.gyroY = Double.parseDouble(gyroY); }

public void setGyroZ(String gyroZ) { this.gyroZ = Double.parseDouble(gyroZ); }

public void setAccX(String accX) { this.accX = Double.parseDouble(accX); }

public void setAccY(String accY) { this.accY = Double.parseDouble(accY); }

public void setAccZ(String accZ) { this.accZ = Double.parseDouble(accZ); }

private void AddTestFeatures () { this.testFeatures = new double[]{
flex1, flex2, flex3, flex4, flex5, gyroX, gyroY, gyroZ,
accX, accY, accZ};
}

public void AddTrainedFeatures(double[] trainedFeatures) { this.trainedFeatures.add(trainedFeatures);
}

public void AddTrainedLabel(String trainedLabel) { this.trainedLabel.add(trainedLabel);
}

private void ComputeDistance() {
int totalTrainedFeatures = this.trainedFeatures.size(); this.distanceList = new double[totalTrainedFeatures][2];

double[] indexTrainedFeature;
double sum;
double distance;

for(int i = 0; i < totalTrainedFeatures; i++) { indexTrainedFeature = this.trainedFeatures.get(i);
sum = 0;
for(int j = 0; j < indexTrainedFeature.length; j++) {
sum += Math.pow(indexTrainedFeature[j] - testFeatures[j], 2); }
distance = Math.sqrt(sum);
this.distanceList[i][0] = distance;
this.distanceList[i][1] = i;
}
}

private void SortDistanceList() {
int distanceListLength = distanceList.length;

for(int i = 0; i < distanceListLength; i++) {
for(int j = 0; j < distanceListLength - 1; j++) { if(distanceList[j][0] > distanceList[j+1][0]) { //swap distance
double temp = distanceList[j][0]; distanceList[j][0] = distanceList[j+1][0]; distanceList[j+1][0] = temp;
//as well as label
double temp2 = distanceList[j][1]; distanceList[j][1] = distanceList[j+1][1]; distanceList[j+1][1] = temp2;
}
}
}
}

private void GetTopLabels() {
for(int i = 0; i < this.k; i++){ targetLabels.add(trainedLabel.get((int) distanceList[i][1])); }
}

private void GetMostNumberOfLabel() {
Map<String, Integer> hashmap = new HashMap<String, Integer>();

for(String label : targetLabels){
if (hashmap.keySet().contains(label))
hashmap.put(label, hashmap.get(label) + 1);
else
hashmap.put(label, 1);
}

for(int counter = 0; counter < 3; counter++) {
String highestLabelCount = "";
int labelCount = 0;

for(Map.Entry<String, Integer> entry : hashmap.entrySet()){ String key = entry.getKey();
Integer value = entry.getValue();
if (value > labelCount){
highestLabelCount = key;
labelCount = value;

}
else if(value == labelCount && highestLabelCount.compareTo(key) > 0) highestLabelCount = key;
}

if(labelCount == 0){
topThreeLabel[counter] = "-"; topThreeLabelCount[counter] = 0;
} else {
topThreeLabel[counter] = highestLabelCount; topThreeLabelCount[counter] = labelCount; }

hashmap.remove(highestLabelCount);
}
}

private void ComputeConfidence() {
for(int i = 0; i < 3; i++) {
topThreeConfidence[i] = (topThreeLabelCount[i] / (double) this.k) * 100; }
}

public void Classify(){
AddTestFeatures();
ComputeDistance();
SortDistanceList();
GetTopLabels();
GetMostNumberOfLabel();
ComputeConfidence();
}

public double GetConfidence(int i) { return topThreeConfidence[i];
}

public String GetLabel(int i) { return topThreeLabel[i];
}
}

## Statistics.java

import java.util.ArrayList;
import java.util.List;

public class Statistics {
private List<Double> speedList; private List<Double> accuracyList;

public Statistics() {
this.speedList = new ArrayList<>();
this.accuracyList = new ArrayList<>();
}

public void setSpeedAccuracyList(List<String[]> gameDataList) { String[] gameRecord;
for(int i = 0; i < gameDataList.size(); i++) {
gameRecord = gameDataList.get(i); speedList.add(Double.parseDouble(gameRecord[0])); accuracyList.add(Double.parseDouble(gameRecord[1])); }
}

public int getGamesPlayedCount() {
return speedList.size();
}

public double getSpeedRecord() {
double speedRecord = 0;
for(int i = 0; i < speedList.size(); i++) { if (speedRecord < speedList.get(i)) { speedRecord = speedList.get(i);
}
}
return speedRecord;
}

public double getAverageSpeed() {
double averageSpeed = 0;
int totalSum = 0;
for(int i = 0; i < speedList.size(); i++) { totalSum += speedList.get(i);
}
averageSpeed = totalSum/speedList.size(); return averageSpeed;
}

public double getAverageAccuracy() {
double averageAccuracy = 0;
int totalSum = 0;
for(int i = 0; i < accuracyList.size(); i++) { totalSum += accuracyList.get(i);
}
averageAccuracy = totalSum/accuracyList.size(); return averageAccuracy;
}
}

## dataset.txt

74736.84,25702.92,24857.14,23652.39,69313.19,408,-197,-368,14552,-2908,9084,N 45892.86,24548.97,14970.70,13155.96,66622.34,-1912,297,631,15604,-1576,7924,K 81509.44,26250.00,27863.13,14796.12,66622.34,-1225,-47,-47,15608,-3104,7156,R 60220.59,25595.24,13735.96,13001.82,61343.28,354,722,-482,15916,-3568,3964,U 57725.12,25275.59,19100.00,17579.62,70726.26,150,-337,52,15820,-2848,4876,V 71207.87,24960.94,27983.19,26250.00,65763.16,383,-125,-209,15236,-2620,7832,N 35311.48,22888.89,15386.14,13155.96,65763.16,1551,-535,129,15452,-3564,5144,K 56041.67,26029.41,26472.97,14623.55,55714.29,54,-155,389,15484,-3804,6996,R 52898.23,25275.59,12798.91,12648.65,58071.43,-445,29,-219,16136,-1224,3496,U 48937.50,24857.14,20936.77,18874.17,54750.00,141,167,-139,16384,-984,2372,V 75798.82,24346.15,28225.35,26585.37,67058.82,-142,-322,-367,15736,-2032,6800,N 49746.84,22610.29,14680.85,12748.64,67058.82,1022,548,862,16096,-1964,1816,K 50858.37,25702.92,26250.00,15147.35,71207.87,1861,-1543,837,16404,440,5636,R 63290.82,25170.16,13259.67,12900.00,49205.02,-321,-125,-78,15544,-2872,5980,U 62500.00,24651.16,21975.90,20438.80,50021.19,1711,-868,72,16208,-688,4908,V 74215.13,22982.67,26029.41,25920.00,70726.26,533,-545,-86,14876,-4004,7404,N 37551.38,21887.02,14396.55,13001.82,68852.46,2539,-313,1588,15592,-3828,4128,K 58071.43,25702.92,26250.00,14854.09,69313.19,-261,-529,-300,15976,-3280,2924,R 55714.29,25170.16,13155.96,13207.72,61343.28,395,-1482,-17,16024,-3848,800,U 58071.43,25920.00,21975.90,20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
.42,121,-101,219,16092,-4492,2724,M 69313.19,24651.16,32361.11,33254.72,65340.31,-168,-628,-169,15876,-4344,2624,S 66622.34,23750.00,30943.12,28225.35,46626.50,-1392,-1081,609,15652,-4164,4452,A 65340.31,23848.10,30265.49,17718.55,57042.25,162,-1002,199,15748,-4108,2300,T 52302.63,18214.29,21105.88,22982.67,74215.13,-128,-554,174,15948,-3328,4632,M 69313.19,25488.13,31359.52,33406.94,71207.87,30,-294,-48,15868,-4476,2676,S 62500.00,24245.52,30534.13,27625.00,44019.23,-310,-870,554,15888,-3716,4444,A 59490.29,23652.39,28968.48,17718.55,52302.63,-2062,-49,582,15596,-4384,1616,T 54434.39,18651.32,21448.93,22518.34,75798.82,14,-479,113,15916,-4156,2304,M 74736.84,25065.28,31081.08,33254.72,65340.31,346,-144,-234,15932,-4240,1708,S

## Glove_final.ino

#include <SoftwareSerial.h>

#include <math.h>

#include<Wire.h>

SoftwareSerial BTserial(0, 1); // RX | TX

// Connect the HC-05 TX to Arduino pin 2 RX.

// Connect the HC-05 RX to Arduino pin 3 TX through a voltage divider.

// Flex Sensor

const float VCC = 5.0; // Measured voltage of Ardunio 5V line 4.98 daw

const float R_DIV = 15000.0; // 15k ohms

const float DIV_4 = 1023.0; //?

const float DIV_2 = 512.0; //?

// Multiplexer

const int selectPins[3] = {11, 12, 13}; // S0~2, S1~3, S2~4

const int zOutput = 5;

const int zInput = A0; // Connect common (Z) to A0 (analog input)

// MPU6050

const int MPU6050_addr=0x68;

int16_t AccX,AccY,AccZ,Temp,GyroX,GyroY,GyroZ;

// FSR

const int fsrAnalogPin = A3; // FSR is connected to analog 3

void setup()

{

// Multiplexer

for (int i = 0; i < 3; i++)

{

pinMode(selectPins[i], OUTPUT);

digitalWrite(selectPins[i], HIGH);

}

pinMode(zInput, INPUT); // Set up Z as an input

pinMode(fsrAnalogPin, INPUT); // Set up fsr as input

Wire.begin();

Wire.beginTransmission(MPU6050_addr);

Wire.write(0x6B);

Wire.write(0);

Wire.endTransmission(true);

Serial.begin(9600);

BTserial.begin(9600);

}

void loop()

{

// Flex Sensor

float flex[7];

// Loop through five pins that are used (Y0 - Y4)

for (byte pin = 0; pin <= 4; pin++)

{

if (pin == 0 && pin == 4)

{

selectMuxPin(pin); // Select one at a time

int inputValue = analogRead(A0); // and read Z

float FlexVoltage = inputValue * VCC / DIV_2;

float FlexResistance = R_DIV * (VCC / FlexVoltage - 1.0);

flex[pin] = FlexResistance;

}

else

{

selectMuxPin(pin); // Select one at a time

int inputValue = analogRead(A0); // and read Z

float FlexVoltage = inputValue * VCC / DIV_4;

float FlexResistance = R_DIV * (VCC / FlexVoltage - 1.0);

flex[pin] = FlexResistance;

}

}

// MPU6050

Wire.beginTransmission(MPU6050_addr);

Wire.write(0x3B);

Wire.endTransmission(false);

Wire.requestFrom(MPU6050_addr,14,true);

AccX=Wire.read()<<8|Wire.read();

AccY=Wire.read()<<8|Wire.read();

AccZ=Wire.read()<<8|Wire.read();

Temp=Wire.read()<<8|Wire.read();

GyroX=Wire.read()<<8|Wire.read();

GyroY=Wire.read()<<8|Wire.read();

GyroZ=Wire.read()<<8|Wire.read();

// FSR

int fsr = analogRead(fsrAnalogPin);

if(fsr > 100) //if fsr is pressed

{

// Send all the data

Serial.println("#" +

String(flex[0]) + "," +

String(flex[1]) + "," +

String(flex[2]) + "," +

String(flex[3]) + "," +

String(flex[4]) + "," +

String(GyroX) + "," +

String(GyroY) + "," +

String(GyroZ) + "," +

String(AccX) + "," +

String(AccY) + "," +

String(AccZ) + "~");

BTserial.println("#" +

String(flex[0]) + "," +

String(flex[1]) + "," +

String(flex[2]) + "," +

String(flex[3]) + "," +

String(flex[4]) + "," +

String(GyroX) + "," +

String(GyroY) + "," +

String(GyroZ) + "," +

String(AccX) + "," +

String(AccY) + "," +

String(AccZ) + "~");

}

delay(1000);

}

// The selectMuxPin function sets the S0, S1, and S2 pins

// accordingly, given a pin from 0-7.

void selectMuxPin(byte pin)

{

for (int i = 0; i < 3; i++)

{

if (pin & (1 << i))

digitalWrite(selectPins[i], HIGH);

else

digitalWrite(selectPins[i], LOW);

}

}
