jvgcalites/FilipinoSignLanguageToTextConverterUsingKNN/(list of files, drawings)

Other design files:
PCB and Schematics/battery_module.pcb
PCB and Schematics/main_module.pcb
