jvgcalites/FilipinoSignLanguageToTextConverterUsingKNN/(commit log)

2020-03-23 March 24,2020
    - initial push
    [battery_module.pcb, battery_module.sch, main_module.pcb, main_module.sch]
2020-03-27 added initial codes
    code of arduino and android studio
2020-04-21 ver1.0
    This version is a modified version of wingoodharry application.
    It can classify A, B, and C hand gestures.
    The UI still needs to be changed and additional dataset must be added.
2020-05-14 version 3.3
    + updated dataset (A-Z)
    + add GestureTyping activity a landscape mode, although it still doesn't work
    - difficulty with classifying letters O and C, K, V, and U
    - landscape mode on GestureTyping activity and MainActivity still needs to be fixed
    ~ plans to add SPACE in the data set, perhaps some basic gestures as well
    ~ create a settings button, let the user configure the value of K, using time delay or pressure sensor as way of input
2020-06-17 updated the dataset
    + The dataset contains 1243 samples and K is set to 3.
    + The Space in the dataset is replaced with "__". Why not only "_"? For some reasons, I have to make it 2 underscores because I gave up lol.
2020-06-19 updated battery module
    + battery module version 3
    [battery_module.pcb, battery_module.sch]
2020-06-20 changed dataset and K
    + dataset contains 45 samples per letter
    + the value of K is 5
2020-09-14 updated battery module
    [battery_module.pcb, battery_module.sch]
2020-09-22 updates
    + change pcb
    + created apk file
    [battery_module.pcb]
